saipurumandla/irrigation-ha/cad/stl/box.stl

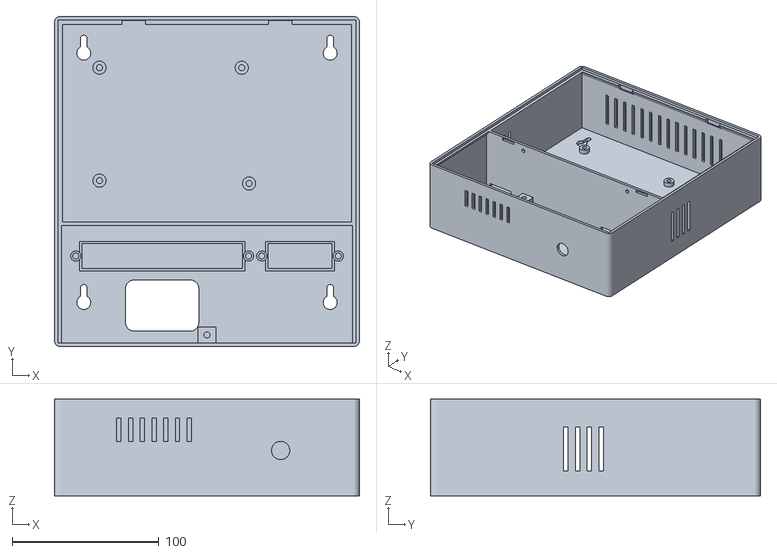
[picture p1: CAD file, 2026-11-06]
cad/stl/box.stl
208.0 x 225.0 x 66.0
