saipurumandla/irrigation-ha/cad/stl/wire_guard.stl

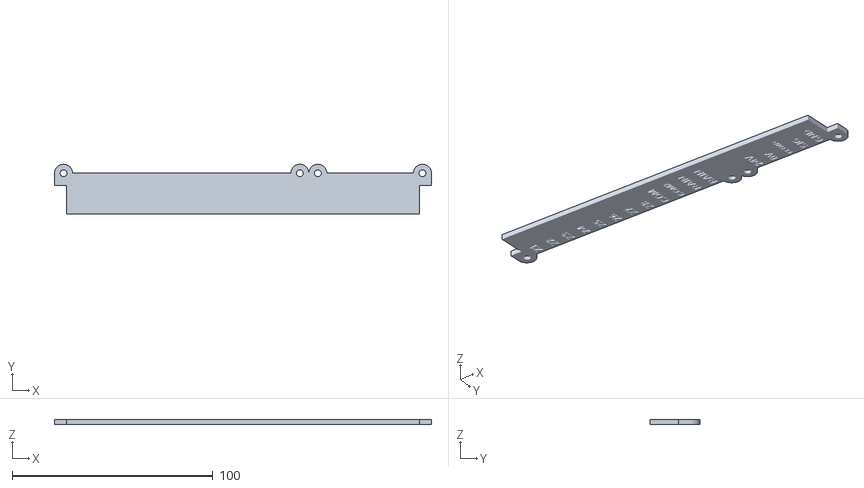
[picture p2: CAD file, 2026-11-06]
cad/stl/wire_guard.stl
188.0 x 24.7 x 2.40
