saipurumandla/irrigation-ha/cad/stl/thumb_knob.stl

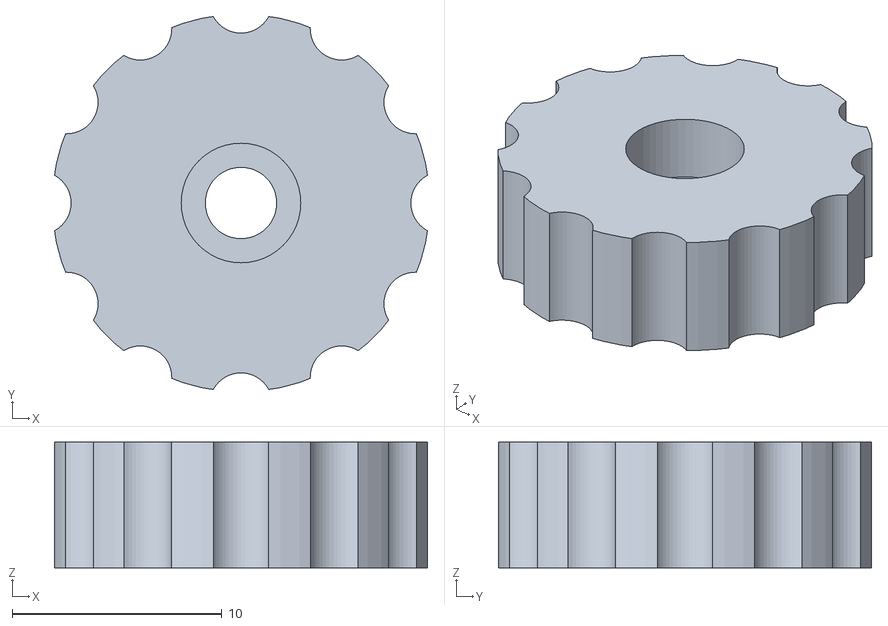
[picture p3: CAD file, 2026-11-06]
cad/stl/thumb_knob.stl
17.8 x 17.8 x 6.00
