saipurumandla/irrigation-ha/cad/stl/lid.stl

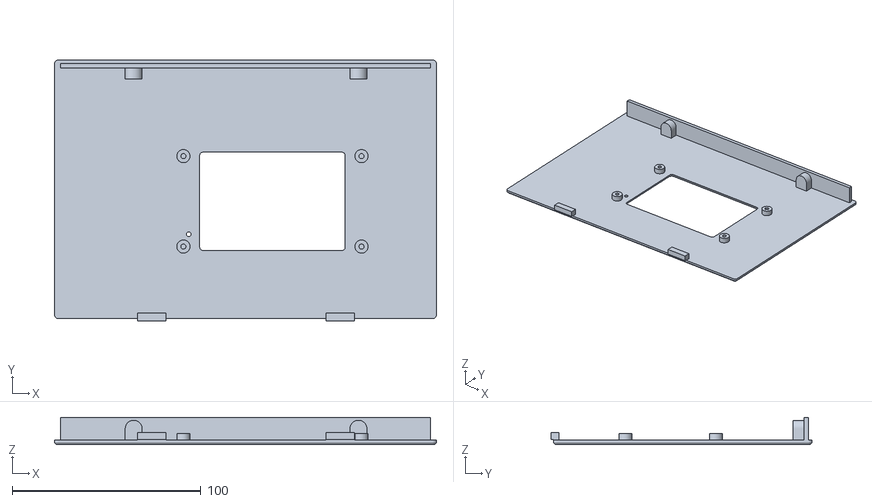
[picture p4: CAD file, 2026-11-06]
cad/stl/lid.stl
202.6 x 138.5 x 14.4
