saipurumandla/irrigation-ha/cad/stl/base.stl

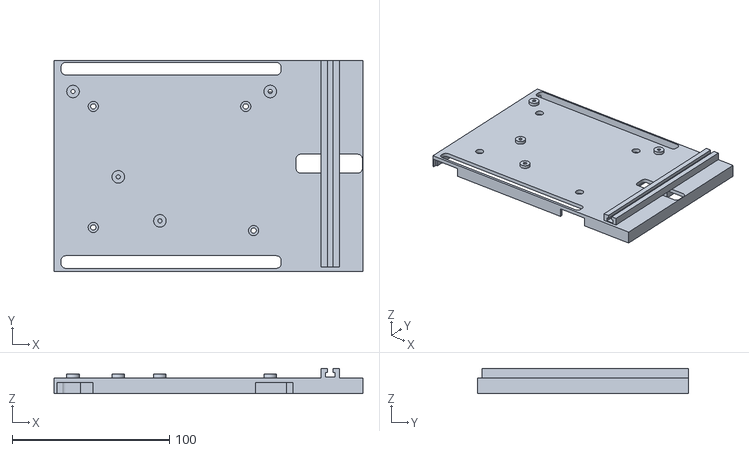
[picture p5: CAD file, 2026-11-06]
cad/stl/base.stl
196.6 x 134.2 x 16.0
