saipurumandla/irrigation-ha/cad/stl/wiring_cover.stl

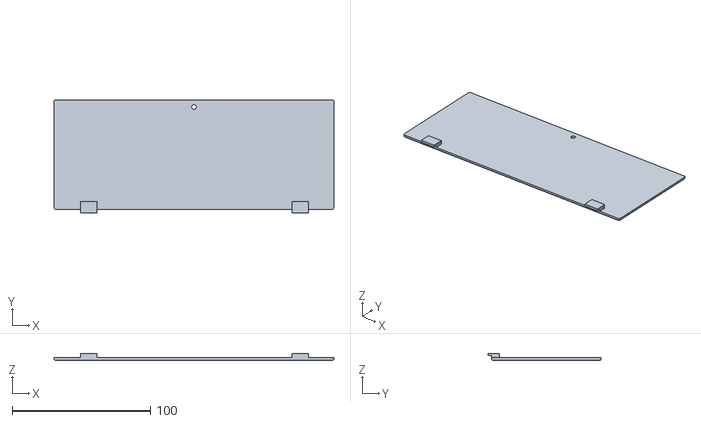
[picture p6: CAD file, 2026-11-06]
cad/stl/wiring_cover.stl
202.6 x 82.0 x 5.40
