saipurumandla/irrigation-ha/cad/stl/clips_labels.stl

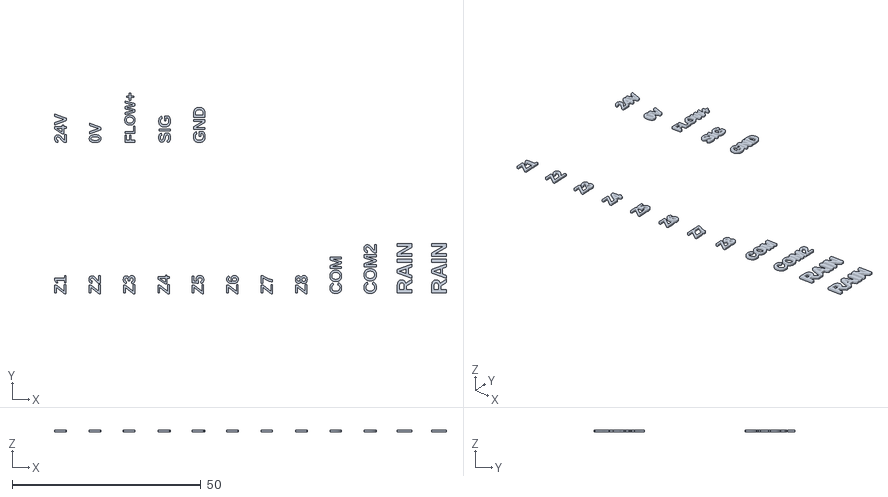
[picture p7: CAD file, 2026-11-06]
cad/stl/clips_labels.stl
103.9 x 53.1 x 0.61
