saipurumandla/irrigation-ha/cad/stl/clips.stl

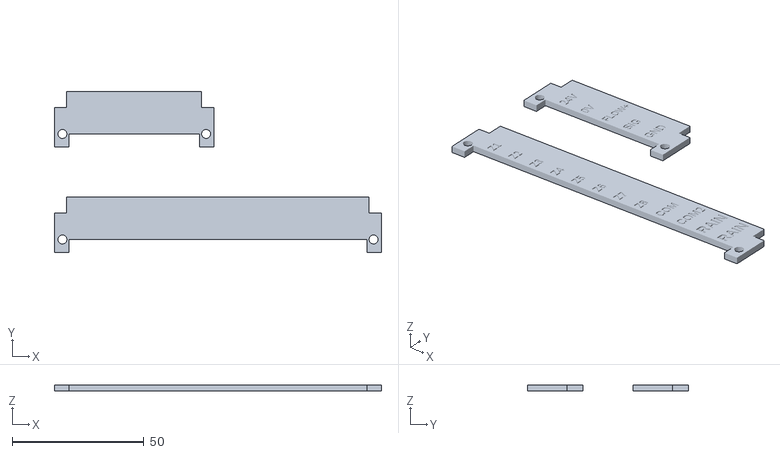
[picture p8: CAD file, 2026-11-06]
cad/stl/clips.stl
124.0 x 61.1 x 2.40
