saipurumandla/irrigation-ha/cad/stl/wall_template.stl

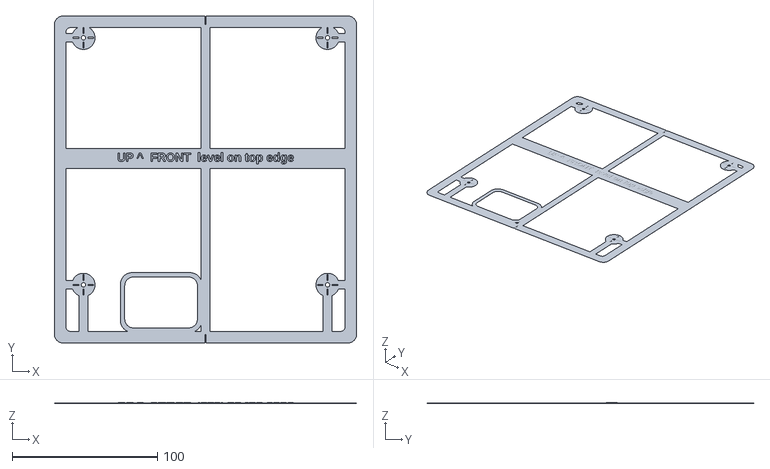
[picture p9: CAD file, 2026-11-06]
cad/stl/wall_template.stl
208.0 x 225.0 x 0.99
