saipurumandla/irrigation-ha/cad/stl/transformer_cover.stl

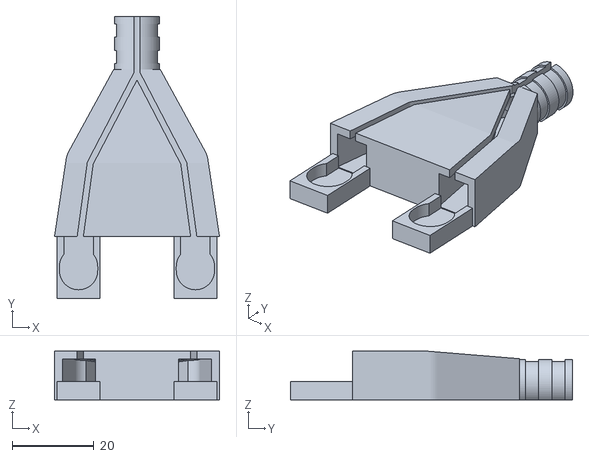
[picture p10: CAD file, 2026-11-06]
cad/stl/transformer_cover.stl
40.5 x 69.3 x 12.0
