saipurumandla/irrigation-ha/firmware/irrigation-screen.yaml

# Irrigation screen: Hosyond / LCDWIKI ES3C35P (ESP32-S3, 8 MB PSRAM, 16 MB flash), 3.5" IPS
# 320x480, ST77922 over QSPI with the ST77922's own (Sitronix) touch on I2C 0x55. It sits in the
# irrigation case's lid and talks to the A8 over its UART socket (5V GND TXD RXD -> A8 S1/S2).
#
# The irrigation box's face: Home, Zones, Schedule, History, Settings. See docs/irrigation-screen.md.
# Pins (ES3C35P spec V1.0 + schematic): LCD CS 10, CLK 12, D0-D3 11/13/14/9; GPIO48 resets the
# whole ST77922 (display and touch); backlight 41 (high = on); touch SDA 38, SCL 39, INT 47; RGB LED 40; audio amp
# enable 1 (low = on); UART0 TX 43 / RX 44 (the A8 link).
# Panel init: the seller's table, read from the factory flash backup
# (~/esp-backups/es3c35p-screen-factory-2026-11-05.bin); see components/st77922_qspi.

substitutions:
  name: irrigation-screen
  friendly_name: Irrigation screen
  # Black edge drawn on the left (and optionally bottom) to balance the panel's own black edge (px).
  bezel_left: "30"
  bezel_bottom: "0"
  # Light theme (chosen 2026-11-05: hides the backlight bleed)
  paper: "0xE9EEF2"
  ink: "0x1B2733"
  muted: "0x5B6B78"
  # Backlight: day hours, idle dim and off (the board has no light sensor).
  day_from: "7"
  day_until: "20"
  dim_after: "30"
  off_after: "60"

esphome:
  name: ${name}
  friendly_name: ${friendly_name}
  includes:
    - screen/a8_link_client.h
    - screen/ui.h
    - screen/history.h
  on_boot:
    priority: 600
    then:
      - output.turn_on: amp_off   # keep the speaker amplifier off (nothing plays audio)
      - lambda: a8link::client().begin(id(a8_uart));
      - lambda: hist::history().begin();
      - script.execute: apply_brightness

esp32:
  variant: esp32s3
  flash_size: 16MB
  framework:
    type: esp-idf

psram:
  mode: octal
  speed: 80MHz

logger:
  hardware_uart: USB_SERIAL_JTAG   # UART0 (the socket) is kept for the A8

api:
  encryption:
    key: !secret irrigation_screen_api_key

ota:
  - platform: esphome
    password: !secret irrigation_screen_ota_password

wifi:
  ssid: !secret wifi_ssid
  password: !secret wifi_password
  ap:
    ssid: "${friendly_name} setup"
  on_connect:
    - lvgl.label.update: {id: wifi_icon, text: "\U000F05A9", text_color: 0x2E7D32}
  on_disconnect:
    - lvgl.label.update: {id: wifi_icon, text: "\U000F05AA", text_color: 0xB3261E}

captive_portal:

text_sensor:
  - platform: wifi_info
    scan_results:
      name: "Wi-Fi networks seen"
      entity_category: diagnostic
    ssid:
      id: wifi_ssid_now
      on_value:
        - lambda: ui::wifi_ssid_cache() = x;
      name: "Wi-Fi network"
      entity_category: diagnostic

# The wired link to the A8 (irrigation.yaml), on the screen's UART socket: our TXD
# (GPIO43) goes to the A8's RX (S2), our RXD (GPIO44) to its TX (S1). Logs go to USB instead.
uart:
  - id: a8_uart
    tx_pin: GPIO43
    rx_pin: GPIO44
    baud_rate: 115200
    rx_buffer_size: 4096

interval:
  - interval: 20ms
    then:
      - lambda: a8link::client().poll();
  - interval: 1s
    then:
      - lambda: a8link::client().tick();
      - lambda: |-
          const long now = id(sntp_time).now().is_valid() ? (long) id(sntp_time).now().timestamp : 0;
          hist::history().set_now(now);
          hist::history().tick(now);
          if (hist::history().changed) { hist::history().changed = false; id(refresh_history).execute(); }
      - if:   # the countdown
          condition:
            lambda: return a8link::client().seconds_left() > 0;
          then:
            - script.execute: refresh_home
            - script.execute: refresh_zones
            - script.execute: refresh_zone
  - interval: 300ms
    then:
      - if:
          condition:
            lambda: return a8link::client().take_changed();
          then:
            - script.execute: refresh_home
            - script.execute: refresh_zones
            - script.execute: refresh_zone
            - script.execute: refresh_sched
            - script.execute: refresh_prog
            - script.execute: refresh_settings

time:
  - platform: sntp
    id: sntp_time
    timezone: America/New_York
    on_time_sync:
      - script.execute: update_clock
    on_time:
      - seconds: 0
        then:
          - script.execute: update_clock
          - script.execute: refresh_home   # day/night icon, "Today" after midnight
          - if:   # follow day/night while awake (not dimmed or off)
              condition:
                lambda: return id(screen_state) == 0;
              then:
                - script.execute: apply_brightness

globals:
  # Backlight levels (%), changed by sliding the left bezel; kept across restarts.
  - id: cur_zone   # the zone open on the zone page (1-8)
    type: int
    initial_value: "1"
  - id: run_min    # minutes chosen on the zone page
    type: int
    initial_value: "10"
  - id: run_zone_pending   # Run pressed: the zone to start once its minutes are sent (0 = none)
    type: int
    initial_value: "0"
  - id: cur_prog     # the program open on the program page (0-3 = A-D)
    type: int
    initial_value: "0"
  - id: prog_shown   # programs added this session but still empty (bit per program)
    type: int
    initial_value: "0"
  - id: wf_ssid       # the network chosen on the Wi-Fi page
    type: std::string
    initial_value: '""'
  - id: hist_view    # 0 = 7 days, 1 = one day
    type: int
    initial_value: "0"
  - id: hist_day     # the day shown in the day view (local day number)
    type: int
    initial_value: "0"
  # Settings PIN: on the screen only (not an HA entity). Always on; default 0000.
  - id: settings_pin_v2
    type: int
    restore_value: true
    initial_value: "0"
  - id: settings_unlocked   # until the screen next turns off
    type: bool
    initial_value: "false"
  - id: pin_mode    # 0 = unlock Settings, 1 = new PIN, 2 = confirm new PIN
    type: int
    initial_value: "0"
  - id: pin_buf
    type: std::string
    initial_value: '""'
  - id: pin_first
    type: std::string
    initial_value: '""'
  - id: slide_last_y
    type: int
    initial_value: "0"
  # While the bezel is being slid: the level shown, saved to the number only on release (each
  # step used to set the number, which re-ran refresh_settings and sent a state to HA every few ms).
  - id: slide_val
    type: float
    initial_value: "0"
  - id: sliding
    type: bool
    initial_value: "false"
  - id: screen_state   # 0 awake, 1 dimmed, 2 off
    type: int
    initial_value: "0"
  - id: is_daytime
    type: std::function<bool()>
    initial_value: |-
      []() {
        auto t = id(sntp_time).now();
        if (!t.is_valid()) return true;
        return t.hour >= (int) id(scr_day_from).state && t.hour < (int) id(scr_day_until).state;
      }

script:
  - id: pin_show
    then:
      - lambda: |-
          static const char *const t[] = {"Enter PIN", "New PIN (4 digits)", "Enter it again"};
          ui::text(id(pin_title), t[id(pin_mode) % 3]);
          ui::text(id(pin_msg), "");
          ui::text(id(pin_dots), "");
      - lvgl.widget.show: pin_sheet
  - id: pin_entered
    then:
      - lambda: |-
          std::string dots;
          for (size_t i = 0; i < 4; i++) dots += i < id(pin_buf).size() ? "* " : "_ ";
          ui::text(id(pin_dots), dots);
          ui::text(id(pin_msg), "");
          if (id(pin_buf).size() < 4) return;
          const std::string got = id(pin_buf);
          id(pin_buf) = "";
          if (id(pin_mode) == 0) {
            if (atoi(got.c_str()) == id(settings_pin_v2)) {
              id(settings_unlocked) = true;
              ui::vis(id(pin_sheet), false);
              id(refresh_settings).execute();
              lv_scr_load(ui::as_obj(id(settings_page)));
            } else {
              ui::text(id(pin_msg), "Wrong PIN");
              ui::text(id(pin_dots), "_ _ _ _ ");
            }
          } else if (id(pin_mode) == 1) {
            id(pin_first) = got;
            id(pin_mode) = 2;
            ui::text(id(pin_title), "Enter it again");
            ui::text(id(pin_dots), "_ _ _ _ ");
          } else {
            if (got == id(pin_first)) {
              id(settings_pin_v2) = atoi(got.c_str());
              id(settings_unlocked) = true;
              ui::vis(id(pin_sheet), false);
              id(refresh_settings).execute();
            } else {
              id(pin_mode) = 1;
              ui::text(id(pin_title), "New PIN (4 digits)");
              ui::text(id(pin_msg), "Didn't match - start again");
              ui::text(id(pin_dots), "_ _ _ _ ");
            }
          }
  - id: refresh_history
    then:
      - lambda: |-
          const long now = id(sntp_time).now().timestamp;
          if (now < 1600000000L) return;
          auto &h = hist::history();
          const int32_t today = hist::local_day(now);
          static const char *const wd[] = {"Sun", "Mon", "Tue", "Wed", "Thu", "Fri", "Sat"};
          static const char *const mo[] = {"Jan","Feb","Mar","Apr","May","Jun","Jul","Aug","Sep","Oct","Nov","Dec"};
          const bool week = id(hist_view) == 0;
          ui::vis(id(hv_week), week);
          ui::vis(id(hv_day), !week);
          ui::bg(id(hs_week), week ? 0x1E6091 : 0xE9EEF2); ui::fg(id(hs_week_l), week ? 0xFFFFFF : ${ink});
          ui::bg(id(hs_day), !week ? 0x1E6091 : 0xE9EEF2); ui::fg(id(hs_day_l), !week ? 0xFFFFFF : ${ink});
          // 7 days: bars scaled to the busiest day
          uint32_t maxs = 600;
          for (int d = 0; d < 7; d++) maxs = std::max(maxs, h.secs(today - (6 - d), 0));
          bool used[8] = {};
          const int H = 150;
          { const int32_t day = today - (6 - 0);
            const auto lt = esphome::ESPTime::from_epoch_local((time_t) (now - (long) (6 - 0) * 86400));
            ui::text(id(hw0_l), 0 == 6 ? std::string("Today") : std::string(wd[(lt.day_of_week + 6) % 7]));
            const uint32_t tot = h.secs(day, 0);
            ui::text(id(hw0_t), tot ? std::to_string((tot + 59) / 60) + "m" : std::string(""));
            int ybase = -22;
            { const uint32_t s = h.secs(day, 1); const int hh = s ? std::max(2, (int) ((uint64_t) s * H / maxs)) : 0;
              ui::vis(id(hw0_s0), hh > 0);
              if (hh > 0) { used[0] = true; lv_obj_set_height(ui::as_obj(id(hw0_s0)), hh); lv_obj_set_y(ui::as_obj(id(hw0_s0)), ybase); ybase -= hh; } }
            { const uint32_t s = h.secs(day, 2); const int hh = s ? std::max(2, (int) ((uint64_t) s * H / maxs)) : 0;
              ui::vis(id(hw0_s1), hh > 0);
              if (hh > 0) { used[1] = true; lv_obj_set_height(ui::as_obj(id(hw0_s1)), hh); lv_obj_set_y(ui::as_obj(id(hw0_s1)), ybase); ybase -= hh; } }
            { const uint32_t s = h.secs(day, 3); const int hh = s ? std::max(2, (int) ((uint64_t) s * H / maxs)) : 0;
              ui::vis(id(hw0_s2), hh > 0);
              if (hh > 0) { used[2] = true; lv_obj_set_height(ui::as_obj(id(hw0_s2)), hh); lv_obj_set_y(ui::as_obj(id(hw0_s2)), ybase); ybase -= hh; } }
            { const uint32_t s = h.secs(day, 4); const int hh = s ? std::max(2, (int) ((uint64_t) s * H / maxs)) : 0;
              ui::vis(id(hw0_s3), hh > 0);
              if (hh > 0) { used[3] = true; lv_obj_set_height(ui::as_obj(id(hw0_s3)), hh); lv_obj_set_y(ui::as_obj(id(hw0_s3)), ybase); ybase -= hh; } }
            { const uint32_t s = h.secs(day, 5); const int hh = s ? std::max(2, (int) ((uint64_t) s * H / maxs)) : 0;
              ui::vis(id(hw0_s4), hh > 0);
              if (hh > 0) { used[4] = true; lv_obj_set_height(ui::as_obj(id(hw0_s4)), hh); lv_obj_set_y(ui::as_obj(id(hw0_s4)), ybase); ybase -= hh; } }
            { const uint32_t s = h.secs(day, 6); const int hh = s ? std::max(2, (int) ((uint64_t) s * H / maxs)) : 0;
              ui::vis(id(hw0_s5), hh > 0);
              if (hh > 0) { used[5] = true; lv_obj_set_height(ui::as_obj(id(hw0_s5)), hh); lv_obj_set_y(ui::as_obj(id(hw0_s5)), ybase); ybase -= hh; } }
            { const uint32_t s = h.secs(day, 7); const int hh = s ? std::max(2, (int) ((uint64_t) s * H / maxs)) : 0;
              ui::vis(id(hw0_s6), hh > 0);
              if (hh > 0) { used[6] = true; lv_obj_set_height(ui::as_obj(id(hw0_s6)), hh); lv_obj_set_y(ui::as_obj(id(hw0_s6)), ybase); ybase -= hh; } }
            { const uint32_t s = h.secs(day, 8); const int hh = s ? std::max(2, (int) ((uint64_t) s * H / maxs)) : 0;
              ui::vis(id(hw0_s7), hh > 0);
              if (hh > 0) { used[7] = true; lv_obj_set_height(ui::as_obj(id(hw0_s7)), hh); lv_obj_set_y(ui::as_obj(id(hw0_s7)), ybase); ybase -= hh; } }
          }
          { const int32_t day = today - (6 - 1);
            const auto lt = esphome::ESPTime::from_epoch_local((time_t) (now - (long) (6 - 1) * 86400));
            ui::text(id(hw1_l), 1 == 6 ? std::string("Today") : std::string(wd[(lt.day_of_week + 6) % 7]));
            const uint32_t tot = h.secs(day, 0);
            ui::text(id(hw1_t), tot ? std::to_string((tot + 59) / 60) + "m" : std::string(""));
            int ybase = -22;
            { const uint32_t s = h.secs(day, 1); const int hh = s ? std::max(2, (int) ((uint64_t) s * H / maxs)) : 0;
              ui::vis(id(hw1_s0), hh > 0);
              if (hh > 0) { used[0] = true; lv_obj_set_height(ui::as_obj(id(hw1_s0)), hh); lv_obj_set_y(ui::as_obj(id(hw1_s0)), ybase); ybase -= hh; } }
            { const uint32_t s = h.secs(day, 2); const int hh = s ? std::max(2, (int) ((uint64_t) s * H / maxs)) : 0;
              ui::vis(id(hw1_s1), hh > 0);
              if (hh > 0) { used[1] = true; lv_obj_set_height(ui::as_obj(id(hw1_s1)), hh); lv_obj_set_y(ui::as_obj(id(hw1_s1)), ybase); ybase -= hh; } }
            { const uint32_t s = h.secs(day, 3); const int hh = s ? std::max(2, (int) ((uint64_t) s * H / maxs)) : 0;
              ui::vis(id(hw1_s2), hh > 0);
              if (hh > 0) { used[2] = true; lv_obj_set_height(ui::as_obj(id(hw1_s2)), hh); lv_obj_set_y(ui::as_obj(id(hw1_s2)), ybase); ybase -= hh; } }
            { const uint32_t s = h.secs(day, 4); const int hh = s ? std::max(2, (int) ((uint64_t) s * H / maxs)) : 0;
              ui::vis(id(hw1_s3), hh > 0);
              if (hh > 0) { used[3] = true; lv_obj_set_height(ui::as_obj(id(hw1_s3)), hh); lv_obj_set_y(ui::as_obj(id(hw1_s3)), ybase); ybase -= hh; } }
            { const uint32_t s = h.secs(day, 5); const int hh = s ? std::max(2, (int) ((uint64_t) s * H / maxs)) : 0;
              ui::vis(id(hw1_s4), hh > 0);
              if (hh > 0) { used[4] = true; lv_obj_set_height(ui::as_obj(id(hw1_s4)), hh); lv_obj_set_y(ui::as_obj(id(hw1_s4)), ybase); ybase -= hh; } }
            { const uint32_t s = h.secs(day, 6); const int hh = s ? std::max(2, (int) ((uint64_t) s * H / maxs)) : 0;
              ui::vis(id(hw1_s5), hh > 0);
              if (hh > 0) { used[5] = true; lv_obj_set_height(ui::as_obj(id(hw1_s5)), hh); lv_obj_set_y(ui::as_obj(id(hw1_s5)), ybase); ybase -= hh; } }
            { const uint32_t s = h.secs(day, 7); const int hh = s ? std::max(2, (int) ((uint64_t) s * H / maxs)) : 0;
              ui::vis(id(hw1_s6), hh > 0);
              if (hh > 0) { used[6] = true; lv_obj_set_height(ui::as_obj(id(hw1_s6)), hh); lv_obj_set_y(ui::as_obj(id(hw1_s6)), ybase); ybase -= hh; } }
            { const uint32_t s = h.secs(day, 8); const int hh = s ? std::max(2, (int) ((uint64_t) s * H / maxs)) : 0;
              ui::vis(id(hw1_s7), hh > 0);
              if (hh > 0) { used[7] = true; lv_obj_set_height(ui::as_obj(id(hw1_s7)), hh); lv_obj_set_y(ui::as_obj(id(hw1_s7)), ybase); ybase -= hh; } }
          }
          { const int32_t day = today - (6 - 2);
            const auto lt = esphome::ESPTime::from_epoch_local((time_t) (now - (long) (6 - 2) * 86400));
            ui::text(id(hw2_l), 2 == 6 ? std::string("Today") : std::string(wd[(lt.day_of_week + 6) % 7]));
            const uint32_t tot = h.secs(day, 0);
            ui::text(id(hw2_t), tot ? std::to_string((tot + 59) / 60) + "m" : std::string(""));
            int ybase = -22;
            { const uint32_t s = h.secs(day, 1); const int hh = s ? std::max(2, (int) ((uint64_t) s * H / maxs)) : 0;
              ui::vis(id(hw2_s0), hh > 0);
              if (hh > 0) { used[0] = true; lv_obj_set_height(ui::as_obj(id(hw2_s0)), hh); lv_obj_set_y(ui::as_obj(id(hw2_s0)), ybase); ybase -= hh; } }
            { const uint32_t s = h.secs(day, 2); const int hh = s ? std::max(2, (int) ((uint64_t) s * H / maxs)) : 0;
              ui::vis(id(hw2_s1), hh > 0);
              if (hh > 0) { used[1] = true; lv_obj_set_height(ui::as_obj(id(hw2_s1)), hh); lv_obj_set_y(ui::as_obj(id(hw2_s1)), ybase); ybase -= hh; } }
            { const uint32_t s = h.secs(day, 3); const int hh = s ? std::max(2, (int) ((uint64_t) s * H / maxs)) : 0;
              ui::vis(id(hw2_s2), hh > 0);
              if (hh > 0) { used[2] = true; lv_obj_set_height(ui::as_obj(id(hw2_s2)), hh); lv_obj_set_y(ui::as_obj(id(hw2_s2)), ybase); ybase -= hh; } }
            { const uint32_t s = h.secs(day, 4); const int hh = s ? std::max(2, (int) ((uint64_t) s * H / maxs)) : 0;
              ui::vis(id(hw2_s3), hh > 0);
              if (hh > 0) { used[3] = true; lv_obj_set_height(ui::as_obj(id(hw2_s3)), hh); lv_obj_set_y(ui::as_obj(id(hw2_s3)), ybase); ybase -= hh; } }
            { const uint32_t s = h.secs(day, 5); const int hh = s ? std::max(2, (int) ((uint64_t) s * H / maxs)) : 0;
              ui::vis(id(hw2_s4), hh > 0);
              if (hh > 0) { used[4] = true; lv_obj_set_height(ui::as_obj(id(hw2_s4)), hh); lv_obj_set_y(ui::as_obj(id(hw2_s4)), ybase); ybase -= hh; } }
            { const uint32_t s = h.secs(day, 6); const int hh = s ? std::max(2, (int) ((uint64_t) s * H / maxs)) : 0;
              ui::vis(id(hw2_s5), hh > 0);
              if (hh > 0) { used[5] = true; lv_obj_set_height(ui::as_obj(id(hw2_s5)), hh); lv_obj_set_y(ui::as_obj(id(hw2_s5)), ybase); ybase -= hh; } }
            { const uint32_t s = h.secs(day, 7); const int hh = s ? std::max(2, (int) ((uint64_t) s * H / maxs)) : 0;
              ui::vis(id(hw2_s6), hh > 0);
              if (hh > 0) { used[6] = true; lv_obj_set_height(ui::as_obj(id(hw2_s6)), hh); lv_obj_set_y(ui::as_obj(id(hw2_s6)), ybase); ybase -= hh; } }
            { const uint32_t s = h.secs(day, 8); const int hh = s ? std::max(2, (int) ((uint64_t) s * H / maxs)) : 0;
              ui::vis(id(hw2_s7), hh > 0);
              if (hh > 0) { used[7] = true; lv_obj_set_height(ui::as_obj(id(hw2_s7)), hh); lv_obj_set_y(ui::as_obj(id(hw2_s7)), ybase); ybase -= hh; } }
          }
          { const int32_t day = today - (6 - 3);
            const auto lt = esphome::ESPTime::from_epoch_local((time_t) (now - (long) (6 - 3) * 86400));
            ui::text(id(hw3_l), 3 == 6 ? std::string("Today") : std::string(wd[(lt.day_of_week + 6) % 7]));
            const uint32_t tot = h.secs(day, 0);
            ui::text(id(hw3_t), tot ? std::to_string((tot + 59) / 60) + "m" : std::string(""));
            int ybase = -22;
            { const uint32_t s = h.secs(day, 1); const int hh = s ? std::max(2, (int) ((uint64_t) s * H / maxs)) : 0;
              ui::vis(id(hw3_s0), hh > 0);
              if (hh > 0) { used[0] = true; lv_obj_set_height(ui::as_obj(id(hw3_s0)), hh); lv_obj_set_y(ui::as_obj(id(hw3_s0)), ybase); ybase -= hh; } }
            { const uint32_t s = h.secs(day, 2); const int hh = s ? std::max(2, (int) ((uint64_t) s * H / maxs)) : 0;
              ui::vis(id(hw3_s1), hh > 0);
              if (hh > 0) { used[1] = true; lv_obj_set_height(ui::as_obj(id(hw3_s1)), hh); lv_obj_set_y(ui::as_obj(id(hw3_s1)), ybase); ybase -= hh; } }
            { const uint32_t s = h.secs(day, 3); const int hh = s ? std::max(2, (int) ((uint64_t) s * H / maxs)) : 0;
              ui::vis(id(hw3_s2), hh > 0);
              if (hh > 0) { used[2] = true; lv_obj_set_height(ui::as_obj(id(hw3_s2)), hh); lv_obj_set_y(ui::as_obj(id(hw3_s2)), ybase); ybase -= hh; } }
            { const uint32_t s = h.secs(day, 4); const int hh = s ? std::max(2, (int) ((uint64_t) s * H / maxs)) : 0;
              ui::vis(id(hw3_s3), hh > 0);
              if (hh > 0) { used[3] = true; lv_obj_set_height(ui::as_obj(id(hw3_s3)), hh); lv_obj_set_y(ui::as_obj(id(hw3_s3)), ybase); ybase -= hh; } }
            { const uint32_t s = h.secs(day, 5); const int hh = s ? std::max(2, (int) ((uint64_t) s * H / maxs)) : 0;
              ui::vis(id(hw3_s4), hh > 0);
              if (hh > 0) { used[4] = true; lv_obj_set_height(ui::as_obj(id(hw3_s4)), hh); lv_obj_set_y(ui::as_obj(id(hw3_s4)), ybase); ybase -= hh; } }
            { const uint32_t s = h.secs(day, 6); const int hh = s ? std::max(2, (int) ((uint64_t) s * H / maxs)) : 0;
              ui::vis(id(hw3_s5), hh > 0);
              if (hh > 0) { used[5] = true; lv_obj_set_height(ui::as_obj(id(hw3_s5)), hh); lv_obj_set_y(ui::as_obj(id(hw3_s5)), ybase); ybase -= hh; } }
            { const uint32_t s = h.secs(day, 7); const int hh = s ? std::max(2, (int) ((uint64_t) s * H / maxs)) : 0;
              ui::vis(id(hw3_s6), hh > 0);
              if (hh > 0) { used[6] = true; lv_obj_set_height(ui::as_obj(id(hw3_s6)), hh); lv_obj_set_y(ui::as_obj(id(hw3_s6)), ybase); ybase -= hh; } }
            { const uint32_t s = h.secs(day, 8); const int hh = s ? std::max(2, (int) ((uint64_t) s * H / maxs)) : 0;
              ui::vis(id(hw3_s7), hh > 0);
              if (hh > 0) { used[7] = true; lv_obj_set_height(ui::as_obj(id(hw3_s7)), hh); lv_obj_set_y(ui::as_obj(id(hw3_s7)), ybase); ybase -= hh; } }
          }
          { const int32_t day = today - (6 - 4);
            const auto lt = esphome::ESPTime::from_epoch_local((time_t) (now - (long) (6 - 4) * 86400));
            ui::text(id(hw4_l), 4 == 6 ? std::string("Today") : std::string(wd[(lt.day_of_week + 6) % 7]));
            const uint32_t tot = h.secs(day, 0);
            ui::text(id(hw4_t), tot ? std::to_string((tot + 59) / 60) + "m" : std::string(""));
            int ybase = -22;
            { const uint32_t s = h.secs(day, 1); const int hh = s ? std::max(2, (int) ((uint64_t) s * H / maxs)) : 0;
              ui::vis(id(hw4_s0), hh > 0);
              if (hh > 0) { used[0] = true; lv_obj_set_height(ui::as_obj(id(hw4_s0)), hh); lv_obj_set_y(ui::as_obj(id(hw4_s0)), ybase); ybase -= hh; } }
            { const uint32_t s = h.secs(day, 2); const int hh = s ? std::max(2, (int) ((uint64_t) s * H / maxs)) : 0;
              ui::vis(id(hw4_s1), hh > 0);
              if (hh > 0) { used[1] = true; lv_obj_set_height(ui::as_obj(id(hw4_s1)), hh); lv_obj_set_y(ui::as_obj(id(hw4_s1)), ybase); ybase -= hh; } }
            { const uint32_t s = h.secs(day, 3); const int hh = s ? std::max(2, (int) ((uint64_t) s * H / maxs)) : 0;
              ui::vis(id(hw4_s2), hh > 0);
              if (hh > 0) { used[2] = true; lv_obj_set_height(ui::as_obj(id(hw4_s2)), hh); lv_obj_set_y(ui::as_obj(id(hw4_s2)), ybase); ybase -= hh; } }
            { const uint32_t s = h.secs(day, 4); const int hh = s ? std::max(2, (int) ((uint64_t) s * H / maxs)) : 0;
              ui::vis(id(hw4_s3), hh > 0);
              if (hh > 0) { used[3] = true; lv_obj_set_height(ui::as_obj(id(hw4_s3)), hh); lv_obj_set_y(ui::as_obj(id(hw4_s3)), ybase); ybase -= hh; } }
            { const uint32_t s = h.secs(day, 5); const int hh = s ? std::max(2, (int) ((uint64_t) s * H / maxs)) : 0;
              ui::vis(id(hw4_s4), hh > 0);
              if (hh > 0) { used[4] = true; lv_obj_set_height(ui::as_obj(id(hw4_s4)), hh); lv_obj_set_y(ui::as_obj(id(hw4_s4)), ybase); ybase -= hh; } }
            { const uint32_t s = h.secs(day, 6); const int hh = s ? std::max(2, (int) ((uint64_t) s * H / maxs)) : 0;
              ui::vis(id(hw4_s5), hh > 0);
              if (hh > 0) { used[5] = true; lv_obj_set_height(ui::as_obj(id(hw4_s5)), hh); lv_obj_set_y(ui::as_obj(id(hw4_s5)), ybase); ybase -= hh; } }
            { const uint32_t s = h.secs(day, 7); const int hh = s ? std::max(2, (int) ((uint64_t) s * H / maxs)) : 0;
              ui::vis(id(hw4_s6), hh > 0);
              if (hh > 0) { used[6] = true; lv_obj_set_height(ui::as_obj(id(hw4_s6)), hh); lv_obj_set_y(ui::as_obj(id(hw4_s6)), ybase); ybase -= hh; } }
            { const uint32_t s = h.secs(day, 8); const int hh = s ? std::max(2, (int) ((uint64_t) s * H / maxs)) : 0;
              ui::vis(id(hw4_s7), hh > 0);
              if (hh > 0) { used[7] = true; lv_obj_set_height(ui::as_obj(id(hw4_s7)), hh); lv_obj_set_y(ui::as_obj(id(hw4_s7)), ybase); ybase -= hh; } }
          }
          { const int32_t day = today - (6 - 5);
            const auto lt = esphome::ESPTime::from_epoch_local((time_t) (now - (long) (6 - 5) * 86400));
            ui::text(id(hw5_l), 5 == 6 ? std::string("Today") : std::string(wd[(lt.day_of_week + 6) % 7]));
            const uint32_t tot = h.secs(day, 0);
            ui::text(id(hw5_t), tot ? std::to_string((tot + 59) / 60) + "m" : std::string(""));
            int ybase = -22;
            { const uint32_t s = h.secs(day, 1); const int hh = s ? std::max(2, (int) ((uint64_t) s * H / maxs)) : 0;
              ui::vis(id(hw5_s0), hh > 0);
              if (hh > 0) { used[0] = true; lv_obj_set_height(ui::as_obj(id(hw5_s0)), hh); lv_obj_set_y(ui::as_obj(id(hw5_s0)), ybase); ybase -= hh; } }
            { const uint32_t s = h.secs(day, 2); const int hh = s ? std::max(2, (int) ((uint64_t) s * H / maxs)) : 0;
              ui::vis(id(hw5_s1), hh > 0);
              if (hh > 0) { used[1] = true; lv_obj_set_height(ui::as_obj(id(hw5_s1)), hh); lv_obj_set_y(ui::as_obj(id(hw5_s1)), ybase); ybase -= hh; } }
            { const uint32_t s = h.secs(day, 3); const int hh = s ? std::max(2, (int) ((uint64_t) s * H / maxs)) : 0;
              ui::vis(id(hw5_s2), hh > 0);
              if (hh > 0) { used[2] = true; lv_obj_set_height(ui::as_obj(id(hw5_s2)), hh); lv_obj_set_y(ui::as_obj(id(hw5_s2)), ybase); ybase -= hh; } }
            { const uint32_t s = h.secs(day, 4); const int hh = s ? std::max(2, (int) ((uint64_t) s * H / maxs)) : 0;
              ui::vis(id(hw5_s3), hh > 0);
              if (hh > 0) { used[3] = true; lv_obj_set_height(ui::as_obj(id(hw5_s3)), hh); lv_obj_set_y(ui::as_obj(id(hw5_s3)), ybase); ybase -= hh; } }
            { const uint32_t s = h.secs(day, 5); const int hh = s ? std::max(2, (int) ((uint64_t) s * H / maxs)) : 0;
              ui::vis(id(hw5_s4), hh > 0);
              if (hh > 0) { used[4] = true; lv_obj_set_height(ui::as_obj(id(hw5_s4)), hh); lv_obj_set_y(ui::as_obj(id(hw5_s4)), ybase); ybase -= hh; } }
            { const uint32_t s = h.secs(day, 6); const int hh = s ? std::max(2, (int) ((uint64_t) s * H / maxs)) : 0;
              ui::vis(id(hw5_s5), hh > 0);
              if (hh > 0) { used[5] = true; lv_obj_set_height(ui::as_obj(id(hw5_s5)), hh); lv_obj_set_y(ui::as_obj(id(hw5_s5)), ybase); ybase -= hh; } }
            { const uint32_t s = h.secs(day, 7); const int hh = s ? std::max(2, (int) ((uint64_t) s * H / maxs)) : 0;
              ui::vis(id(hw5_s6), hh > 0);
              if (hh > 0) { used[6] = true; lv_obj_set_height(ui::as_obj(id(hw5_s6)), hh); lv_obj_set_y(ui::as_obj(id(hw5_s6)), ybase); ybase -= hh; } }
            { const uint32_t s = h.secs(day, 8); const int hh = s ? std::max(2, (int) ((uint64_t) s * H / maxs)) : 0;
              ui::vis(id(hw5_s7), hh > 0);
              if (hh > 0) { used[7] = true; lv_obj_set_height(ui::as_obj(id(hw5_s7)), hh); lv_obj_set_y(ui::as_obj(id(hw5_s7)), ybase); ybase -= hh; } }
          }
          { const int32_t day = today - (6 - 6);
            const auto lt = esphome::ESPTime::from_epoch_local((time_t) (now - (long) (6 - 6) * 86400));
            ui::text(id(hw6_l), 6 == 6 ? std::string("Today") : std::string(wd[(lt.day_of_week + 6) % 7]));
            const uint32_t tot = h.secs(day, 0);
            ui::text(id(hw6_t), tot ? std::to_string((tot + 59) / 60) + "m" : std::string(""));
            int ybase = -22;
            { const uint32_t s = h.secs(day, 1); const int hh = s ? std::max(2, (int) ((uint64_t) s * H / maxs)) : 0;
              ui::vis(id(hw6_s0), hh > 0);
              if (hh > 0) { used[0] = true; lv_obj_set_height(ui::as_obj(id(hw6_s0)), hh); lv_obj_set_y(ui::as_obj(id(hw6_s0)), ybase); ybase -= hh; } }
            { const uint32_t s = h.secs(day, 2); const int hh = s ? std::max(2, (int) ((uint64_t) s * H / maxs)) : 0;
              ui::vis(id(hw6_s1), hh > 0);
              if (hh > 0) { used[1] = true; lv_obj_set_height(ui::as_obj(id(hw6_s1)), hh); lv_obj_set_y(ui::as_obj(id(hw6_s1)), ybase); ybase -= hh; } }
            { const uint32_t s = h.secs(day, 3); const int hh = s ? std::max(2, (int) ((uint64_t) s * H / maxs)) : 0;
              ui::vis(id(hw6_s2), hh > 0);
              if (hh > 0) { used[2] = true; lv_obj_set_height(ui::as_obj(id(hw6_s2)), hh); lv_obj_set_y(ui::as_obj(id(hw6_s2)), ybase); ybase -= hh; } }
            { const uint32_t s = h.secs(day, 4); const int hh = s ? std::max(2, (int) ((uint64_t) s * H / maxs)) : 0;
              ui::vis(id(hw6_s3), hh > 0);
              if (hh > 0) { used[3] = true; lv_obj_set_height(ui::as_obj(id(hw6_s3)), hh); lv_obj_set_y(ui::as_obj(id(hw6_s3)), ybase); ybase -= hh; } }
            { const uint32_t s = h.secs(day, 5); const int hh = s ? std::max(2, (int) ((uint64_t) s * H / maxs)) : 0;
              ui::vis(id(hw6_s4), hh > 0);
              if (hh > 0) { used[4] = true; lv_obj_set_height(ui::as_obj(id(hw6_s4)), hh); lv_obj_set_y(ui::as_obj(id(hw6_s4)), ybase); ybase -= hh; } }
            { const uint32_t s = h.secs(day, 6); const int hh = s ? std::max(2, (int) ((uint64_t) s * H / maxs)) : 0;
              ui::vis(id(hw6_s5), hh > 0);
              if (hh > 0) { used[5] = true; lv_obj_set_height(ui::as_obj(id(hw6_s5)), hh); lv_obj_set_y(ui::as_obj(id(hw6_s5)), ybase); ybase -= hh; } }
            { const uint32_t s = h.secs(day, 7); const int hh = s ? std::max(2, (int) ((uint64_t) s * H / maxs)) : 0;
              ui::vis(id(hw6_s6), hh > 0);
              if (hh > 0) { used[6] = true; lv_obj_set_height(ui::as_obj(id(hw6_s6)), hh); lv_obj_set_y(ui::as_obj(id(hw6_s6)), ybase); ybase -= hh; } }
            { const uint32_t s = h.secs(day, 8); const int hh = s ? std::max(2, (int) ((uint64_t) s * H / maxs)) : 0;
              ui::vis(id(hw6_s7), hh > 0);
              if (hh > 0) { used[7] = true; lv_obj_set_height(ui::as_obj(id(hw6_s7)), hh); lv_obj_set_y(ui::as_obj(id(hw6_s7)), ybase); ybase -= hh; } }
          }
          ui::vis(id(hl0), used[0]); ui::text(id(hl0_n), ui::zone_name(1));
          ui::vis(id(hl1), used[1]); ui::text(id(hl1_n), ui::zone_name(2));
          ui::vis(id(hl2), used[2]); ui::text(id(hl2_n), ui::zone_name(3));
          ui::vis(id(hl3), used[3]); ui::text(id(hl3_n), ui::zone_name(4));
          ui::vis(id(hl4), used[4]); ui::text(id(hl4_n), ui::zone_name(5));
          ui::vis(id(hl5), used[5]); ui::text(id(hl5_n), ui::zone_name(6));
          ui::vis(id(hl6), used[6]); ui::text(id(hl6_n), ui::zone_name(7));
          ui::vis(id(hl7), used[7]); ui::text(id(hl7_n), ui::zone_name(8));
          // one day
          {
            const int32_t day = id(hist_day);
            const auto lt = esphome::ESPTime::from_epoch_local((time_t) (now - (long) (today - day) * 86400));
            std::string title = day == today ? std::string("Today") : day == today - 1 ? std::string("Yesterday")
                : std::string(wd[(lt.day_of_week + 6) % 7]) + ", " + mo[(lt.month + 11) % 12] + " " + std::to_string(lt.day_of_month);
            ui::text(id(hd_title), title);
            const uint32_t tot = h.secs(day, 0);
            ui::text(id(hd_total), std::to_string((tot + 59) / 60) + " min");
            ui::vis(id(hd_none), tot == 0);
            uint32_t mx = 60;
            for (int z = 1; z <= 8; z++) mx = std::max(mx, h.secs(day, z));
            { const uint32_t s = h.secs(day, 1);
              ui::vis(id(hd_r0), s > 0);
              ui::text(id(hd_r0_n), ui::zone_name(1));
              ui::text(id(hd_r0_s), h.starts(day, 1));
              lv_obj_set_width(ui::as_obj(id(hd_r0_b)), s ? std::max(3, (int) ((uint64_t) s * 150 / mx)) : 0);
              ui::text(id(hd_r0_m), std::to_string((s + 59) / 60) + " min"); }
            { const uint32_t s = h.secs(day, 2);
              ui::vis(id(hd_r1), s > 0);
              ui::text(id(hd_r1_n), ui::zone_name(2));
              ui::text(id(hd_r1_s), h.starts(day, 2));
              lv_obj_set_width(ui::as_obj(id(hd_r1_b)), s ? std::max(3, (int) ((uint64_t) s * 150 / mx)) : 0);
              ui::text(id(hd_r1_m), std::to_string((s + 59) / 60) + " min"); }
            { const uint32_t s = h.secs(day, 3);
              ui::vis(id(hd_r2), s > 0);
              ui::text(id(hd_r2_n), ui::zone_name(3));
              ui::text(id(hd_r2_s), h.starts(day, 3));
              lv_obj_set_width(ui::as_obj(id(hd_r2_b)), s ? std::max(3, (int) ((uint64_t) s * 150 / mx)) : 0);
              ui::text(id(hd_r2_m), std::to_string((s + 59) / 60) + " min"); }
            { const uint32_t s = h.secs(day, 4);
              ui::vis(id(hd_r3), s > 0);
              ui::text(id(hd_r3_n), ui::zone_name(4));
              ui::text(id(hd_r3_s), h.starts(day, 4));
              lv_obj_set_width(ui::as_obj(id(hd_r3_b)), s ? std::max(3, (int) ((uint64_t) s * 150 / mx)) : 0);
              ui::text(id(hd_r3_m), std::to_string((s + 59) / 60) + " min"); }
            { const uint32_t s = h.secs(day, 5);
              ui::vis(id(hd_r4), s > 0);
              ui::text(id(hd_r4_n), ui::zone_name(5));
              ui::text(id(hd_r4_s), h.starts(day, 5));
              lv_obj_set_width(ui::as_obj(id(hd_r4_b)), s ? std::max(3, (int) ((uint64_t) s * 150 / mx)) : 0);
              ui::text(id(hd_r4_m), std::to_string((s + 59) / 60) + " min"); }
            { const uint32_t s = h.secs(day, 6);
              ui::vis(id(hd_r5), s > 0);
              ui::text(id(hd_r5_n), ui::zone_name(6));
              ui::text(id(hd_r5_s), h.starts(day, 6));
              lv_obj_set_width(ui::as_obj(id(hd_r5_b)), s ? std::max(3, (int) ((uint64_t) s * 150 / mx)) : 0);
              ui::text(id(hd_r5_m), std::to_string((s + 59) / 60) + " min"); }
            { const uint32_t s = h.secs(day, 7);
              ui::vis(id(hd_r6), s > 0);
              ui::text(id(hd_r6_n), ui::zone_name(7));
              ui::text(id(hd_r6_s), h.starts(day, 7));
              lv_obj_set_width(ui::as_obj(id(hd_r6_b)), s ? std::max(3, (int) ((uint64_t) s * 150 / mx)) : 0);
              ui::text(id(hd_r6_m), std::to_string((s + 59) / 60) + " min"); }
            { const uint32_t s = h.secs(day, 8);
              ui::vis(id(hd_r7), s > 0);
              ui::text(id(hd_r7_n), ui::zone_name(8));
              ui::text(id(hd_r7_s), h.starts(day, 8));
              lv_obj_set_width(ui::as_obj(id(hd_r7_b)), s ? std::max(3, (int) ((uint64_t) s * 150 / mx)) : 0);
              ui::text(id(hd_r7_m), std::to_string((s + 59) / 60) + " min"); }
          }
  - id: join_wifi
    parameters:
      ssid: std::string
      password: std::string
    then:
      - lambda: |-
          ui::link().send_wifi(ssid, password);   // the A8 joins too
          ui::text(id(wf_status), "Connecting to " + ssid + "...");
          ui::fg(id(wf_status), ${muted});
      - wifi.configure:
          ssid: !lambda return ssid;
          password: !lambda return password;
          save: true
          timeout: 30s
          on_connect:
            - lambda: |-
                ui::text(id(wf_status), "Connected to " + ui::wifi_current());
                ui::fg(id(wf_status), 0x2E7D32);
          on_error:
            - lambda: |-
                ui::text(id(wf_status), "Couldn't connect - kept " + ui::wifi_current());
                ui::fg(id(wf_status), 0xB3261E);
  - id: refresh_wifi
    then:
      - lambda: |-
          auto *w = wifi::global_wifi_component;
          const std::string cur = ui::wifi_current();
          ui::text(id(wf_cur), cur.empty() ? std::string("Not connected") : cur + "   (" + std::to_string((int) w->wifi_rssi()) + " dBm)");
          auto nets = ui::wifi_networks();
          ui::vis(id(wf_n0), 0 < (int) nets.size());
          if (0 < (int) nets.size()) ui::text(id(wf_n0_l), ui::ascii(nets[0].first) + (nets[0].first == cur ? "   (connected)" : ""));
          ui::vis(id(wf_n1), 1 < (int) nets.size());
          if (1 < (int) nets.size()) ui::text(id(wf_n1_l), ui::ascii(nets[1].first) + (nets[1].first == cur ? "   (connected)" : ""));
          ui::vis(id(wf_n2), 2 < (int) nets.size());
          if (2 < (int) nets.size()) ui::text(id(wf_n2_l), ui::ascii(nets[2].first) + (nets[2].first == cur ? "   (connected)" : ""));
          ui::vis(id(wf_n3), 3 < (int) nets.size());
          if (3 < (int) nets.size()) ui::text(id(wf_n3_l), ui::ascii(nets[3].first) + (nets[3].first == cur ? "   (connected)" : ""));
          ui::vis(id(wf_n4), 4 < (int) nets.size());
          if (4 < (int) nets.size()) ui::text(id(wf_n4_l), ui::ascii(nets[4].first) + (nets[4].first == cur ? "   (connected)" : ""));
          ui::vis(id(wf_n5), 5 < (int) nets.size());
          if (5 < (int) nets.size()) ui::text(id(wf_n5_l), ui::ascii(nets[5].first) + (nets[5].first == cur ? "   (connected)" : ""));
          ui::vis(id(wf_n6), 6 < (int) nets.size());
          if (6 < (int) nets.size()) ui::text(id(wf_n6_l), ui::ascii(nets[6].first) + (nets[6].first == cur ? "   (connected)" : ""));
          ui::vis(id(wf_n7), 7 < (int) nets.size());
          if (7 < (int) nets.size()) ui::text(id(wf_n7_l), ui::ascii(nets[7].first) + (nets[7].first == cur ? "   (connected)" : ""));
  - id: rename_save
    then:
      - lambda: |-
          const std::string nm = ui::ta_text(id(rn_text));
          const std::string key = "text.zone_" + std::to_string(id(cur_zone)) + "_name";
          ESP_LOGI("ui", "Rename zone %d -> \"%s\" (%s)", id(cur_zone), nm.c_str(), key.c_str());
          ui::link().set(key, nm);
      - lvgl.widget.hide: rn_sheet
  - id: refresh_settings
    then:
      - lambda: |-
          ui::text(id(sc_pin_state), id(settings_pin_v2) == 0 ? "Default 0000 - set your own" : "Your own PIN is set");
          ui::text(id(sc_pin_set_l), "Set PIN");
          ui::vis(id(sc_pin_rm), id(settings_pin_v2) != 0);
          ui::text(id(st_wifi), ui::wifi_current().empty() ? std::string("Not connected") : ui::wifi_current());
          ui::text(id(su_z1_n), ui::zone_name(1)); ui::checked(id(su_z1), ui::zone_enabled(1));
          ui::text(id(su_z2_n), ui::zone_name(2)); ui::checked(id(su_z2), ui::zone_enabled(2));
          ui::text(id(su_z3_n), ui::zone_name(3)); ui::checked(id(su_z3), ui::zone_enabled(3));
          ui::text(id(su_z4_n), ui::zone_name(4)); ui::checked(id(su_z4), ui::zone_enabled(4));
          ui::text(id(su_z5_n), ui::zone_name(5)); ui::checked(id(su_z5), ui::zone_enabled(5));
          ui::text(id(su_z6_n), ui::zone_name(6)); ui::checked(id(su_z6), ui::zone_enabled(6));
          ui::text(id(su_z7_n), ui::zone_name(7)); ui::checked(id(su_z7), ui::zone_enabled(7));
          ui::text(id(su_z8_n), ui::zone_name(8)); ui::checked(id(su_z8), ui::zone_enabled(8));
          auto idx = [](const std::string &v, std::initializer_list<const char *> o) { int i = 0; for (auto *s : o) { if (v == s) return i; i++; } return -1; };
          ui::dd_select(id(su_rain), idx(ui::get_by_name("select", "Rain sensor input"), {"None","Input 1","Input 2","Input 3","Input 4","Input 5","Input 6","Input 7","Input 8"}));
          ui::dd_select(id(su_raintype), idx(ui::get_by_name("select", "Rain sensor type"), {"Normally closed (opens when wet)","Normally open (closes when wet)"}));
          ui::dd_select(id(su_master), idx(ui::get_by_name("select", "Master valve or pump"), {"None","Relay 1","Relay 2","Relay 3","Relay 4","Relay 5","Relay 6","Relay 7","Relay 8"}));
          ui::dd_select(id(su_water), idx(ui::get_by_name("select", "Water source"), {"Potable","Well","Reclaimed"}));
          ui::text(id(wa_rd), std::to_string(ui::num_by_name("Rain delay")));
          ui::checked(id(wa_skip), ui::link().get("switch.skip_next_run") == "1");
          ui::text(id(wa_gap), std::to_string(ui::num_by_name("Gap between zones")));
          ui::dd_select(id(wa_rules), idx(ui::get_by_name("select", "Watering rules"), {"Off","Warn","Block"}));
          ui::dd_select(id(wa_hours), idx(ui::get_by_name("text", "Watering rules no-water hours"), {"","9:00-17:00","10:00-16:00","8:00-18:00"}));
          ui::text(id(wa_max), std::to_string(ui::num_by_name("Watering rules max minutes per zone")));
          { const std::string ad = ui::get_by_name("text", "Watering rules allowed days"); const uint8_t m = ad.empty() ? 0x7f : ui::days_mask(ad);
            ui::bg(id(wa_d0), (m & 1) ? 0x2E7D32 : 0xE9EEF2); ui::fg(id(wa_d0_l), (m & 1) ? 0xFFFFFF : ${ink});
            ui::bg(id(wa_d1), (m & 2) ? 0x2E7D32 : 0xE9EEF2); ui::fg(id(wa_d1_l), (m & 2) ? 0xFFFFFF : ${ink});
            ui::bg(id(wa_d2), (m & 4) ? 0x2E7D32 : 0xE9EEF2); ui::fg(id(wa_d2_l), (m & 4) ? 0xFFFFFF : ${ink});
            ui::bg(id(wa_d3), (m & 8) ? 0x2E7D32 : 0xE9EEF2); ui::fg(id(wa_d3_l), (m & 8) ? 0xFFFFFF : ${ink});
            ui::bg(id(wa_d4), (m & 16) ? 0x2E7D32 : 0xE9EEF2); ui::fg(id(wa_d4_l), (m & 16) ? 0xFFFFFF : ${ink});
            ui::bg(id(wa_d5), (m & 32) ? 0x2E7D32 : 0xE9EEF2); ui::fg(id(wa_d5_l), (m & 32) ? 0xFFFFFF : ${ink});
            ui::bg(id(wa_d6), (m & 64) ? 0x2E7D32 : 0xE9EEF2); ui::fg(id(wa_d6_l), (m & 64) ? 0xFFFFFF : ${ink});
          }
          ui::text(id(sc_dim), std::to_string((int) id(scr_dim).state));
          ui::text(id(sc_off), std::to_string((int) id(scr_off).state));
          ui::text(id(sc_from), ui::clock12((int) id(scr_day_from).state * 60));
          ui::text(id(sc_until), ui::clock12((int) id(scr_day_until).state * 60));
          ui::text(id(sc_dayb), std::to_string((int) id(scr_day).state));
          ui::text(id(sc_nightb), std::to_string((int) id(scr_night).state));
          ui::text(id(ab_link), ui::link().up() ? "Connected" : "Not connected");
          { const std::string sv = ui::get_by_name("sensor", "Wi-Fi signal"); const float s = sv.empty() ? NAN : strtof(sv.c_str(), nullptr); ui::text(id(ab_a8wifi), std::isnan(s) ? std::string("--") : std::to_string((int) s) + " dBm"); }
          { auto *w = wifi::global_wifi_component; const bool ok = w && w->is_connected();
            ui::text(id(ab_wifi), ok ? std::to_string((int) w->wifi_rssi()) + " dBm" : std::string("Not connected"));
            std::string ip = "--"; if (ok) for (auto &a : w->wifi_sta_ip_addresses()) if (a.is_ip4()) { char b[48]; ip = a.str_to(b); break; }
            ui::text(id(ab_ip), ip); }
          { const time_t bt = App.get_build_time(); const auto t = esphome::ESPTime::from_epoch_local(bt);
            static const char *const mo[] = {"Jan","Feb","Mar","Apr","May","Jun","Jul","Aug","Sep","Oct","Nov","Dec"};
            ui::text(id(ab_fw), std::string(mo[(t.month + 11) % 12]) + " " + std::to_string(t.day_of_month) + ", " + ui::clock12(t.hour * 60 + t.minute)); }
  - id: refresh_sched
    then:
      - lambda: |-
            int shown = 0;
            ui::vis(id(pc0), ui::prog_used(0) || (id(prog_shown) & 1));
            ui::text(id(pc0_when), ui::prog_when(0));
            ui::text(id(pc0_what), ui::prog_what(0));
            ui::checked(id(pc0_sw), ui::prog_on(0));
            if (ui::prog_used(0) || (id(prog_shown) & 1)) shown++;
            ui::vis(id(pc1), ui::prog_used(1) || (id(prog_shown) & 2));
            ui::text(id(pc1_when), ui::prog_when(1));
            ui::text(id(pc1_what), ui::prog_what(1));
            ui::checked(id(pc1_sw), ui::prog_on(1));
            if (ui::prog_used(1) || (id(prog_shown) & 2)) shown++;
            ui::vis(id(pc2), ui::prog_used(2) || (id(prog_shown) & 4));
            ui::text(id(pc2_when), ui::prog_when(2));
            ui::text(id(pc2_what), ui::prog_what(2));
            ui::checked(id(pc2_sw), ui::prog_on(2));
            if (ui::prog_used(2) || (id(prog_shown) & 4)) shown++;
            ui::vis(id(pc3), ui::prog_used(3) || (id(prog_shown) & 8));
            ui::text(id(pc3_when), ui::prog_when(3));
            ui::text(id(pc3_what), ui::prog_what(3));
            ui::checked(id(pc3_sw), ui::prog_on(3));
            if (ui::prog_used(3) || (id(prog_shown) & 8)) shown++;
            ui::vis(id(sched_add), shown < 4);
            const float sa = ui::link().get_float("number.seasonal_adjust");
            ui::text(id(sa_val), std::isnan(sa) ? std::string("--") : std::to_string((int) lroundf(sa)) + "%");
  - id: refresh_prog
    then:
      - lambda: |-
            const int p = id(cur_prog);
            static const char *const L[4] = {"A", "B", "C", "D"};
            ui::text(id(pg_title), std::string("Program ") + L[p & 3]);
            ui::checked(id(pg_sw), ui::prog_on(p));
            const std::string mode = ui::prog_mode(p);
            const char *const opts[4] = {"Days of the week", "Every N days", "Odd dates", "Even dates"};
            { const bool on = mode == opts[0] || (0 == 0 && mode.empty());
              ui::bg(id(pg_m0), on ? 0x1E6091 : 0xE9EEF2); ui::fg(id(pg_m0_l), on ? 0xFFFFFF : ${ink}); }
            { const bool on = mode == opts[1] || (1 == 0 && mode.empty());
              ui::bg(id(pg_m1), on ? 0x1E6091 : 0xE9EEF2); ui::fg(id(pg_m1_l), on ? 0xFFFFFF : ${ink}); }
            { const bool on = mode == opts[2] || (2 == 0 && mode.empty());
              ui::bg(id(pg_m2), on ? 0x1E6091 : 0xE9EEF2); ui::fg(id(pg_m2_l), on ? 0xFFFFFF : ${ink}); }
            { const bool on = mode == opts[3] || (3 == 0 && mode.empty());
              ui::bg(id(pg_m3), on ? 0x1E6091 : 0xE9EEF2); ui::fg(id(pg_m3_l), on ? 0xFFFFFF : ${ink}); }
            const bool custom = mode == "Days of the week" || mode.empty();
            ui::vis(id(pg_days_row), custom);
            ui::vis(id(pg_cyc), mode == "Every N days");
            ui::text(id(pg_cyc_v), std::to_string(ui::prog_every(p)));
            ui::vis(id(pg_next), mode == "Every N days");
            { const int d = ui::prog_starts_in(p);
              ui::text(id(pg_next_v), d <= 0 ? "Today" : d == 1 ? "Tomorrow" : "In " + std::to_string(d) + " days"); }
            const uint8_t dm = ui::prog_days(p);
            ui::bg(id(pg_d0), (dm & 1) ? 0x2E7D32 : 0xE9EEF2); ui::fg(id(pg_d0_l), (dm & 1) ? 0xFFFFFF : ${ink});
            ui::bg(id(pg_d1), (dm & 2) ? 0x2E7D32 : 0xE9EEF2); ui::fg(id(pg_d1_l), (dm & 2) ? 0xFFFFFF : ${ink});
            ui::bg(id(pg_d2), (dm & 4) ? 0x2E7D32 : 0xE9EEF2); ui::fg(id(pg_d2_l), (dm & 4) ? 0xFFFFFF : ${ink});
            ui::bg(id(pg_d3), (dm & 8) ? 0x2E7D32 : 0xE9EEF2); ui::fg(id(pg_d3_l), (dm & 8) ? 0xFFFFFF : ${ink});
            ui::bg(id(pg_d4), (dm & 16) ? 0x2E7D32 : 0xE9EEF2); ui::fg(id(pg_d4_l), (dm & 16) ? 0xFFFFFF : ${ink});
            ui::bg(id(pg_d5), (dm & 32) ? 0x2E7D32 : 0xE9EEF2); ui::fg(id(pg_d5_l), (dm & 32) ? 0xFFFFFF : ${ink});
            ui::bg(id(pg_d6), (dm & 64) ? 0x2E7D32 : 0xE9EEF2); ui::fg(id(pg_d6_l), (dm & 64) ? 0xFFFFFF : ${ink});
            const auto st = ui::starts(p);
            ui::vis(id(pg_s0), 0 < (int) st.size());
            if (0 < (int) st.size()) ui::text(id(pg_s0_l), ui::clock12(st[0]) + "   x");
            ui::vis(id(pg_s1), 1 < (int) st.size());
            if (1 < (int) st.size()) ui::text(id(pg_s1_l), ui::clock12(st[1]) + "   x");
            ui::vis(id(pg_s2), 2 < (int) st.size());
            if (2 < (int) st.size()) ui::text(id(pg_s2_l), ui::clock12(st[2]) + "   x");
            ui::vis(id(pg_s3), 3 < (int) st.size());
            if (3 < (int) st.size()) ui::text(id(pg_s3_l), ui::clock12(st[3]) + "   x");
            ui::vis(id(pg_sadd), st.size() < 4);
            int total = 0;
            ui::vis(id(pg_z1), ui::zone_enabled(1));
            ui::text(id(pg_z1_n), ui::zone_name(1));
            ui::text(id(pg_z1_v), std::to_string(ui::prog_minutes(p, 1)));
            if (ui::zone_enabled(1)) total += ui::prog_minutes(p, 1);
            ui::vis(id(pg_z2), ui::zone_enabled(2));
            ui::text(id(pg_z2_n), ui::zone_name(2));
            ui::text(id(pg_z2_v), std::to_string(ui::prog_minutes(p, 2)));
            if (ui::zone_enabled(2)) total += ui::prog_minutes(p, 2);
            ui::vis(id(pg_z3), ui::zone_enabled(3));
            ui::text(id(pg_z3_n), ui::zone_name(3));
            ui::text(id(pg_z3_v), std::to_string(ui::prog_minutes(p, 3)));
            if (ui::zone_enabled(3)) total += ui::prog_minutes(p, 3);
            ui::vis(id(pg_z4), ui::zone_enabled(4));
            ui::text(id(pg_z4_n), ui::zone_name(4));
            ui::text(id(pg_z4_v), std::to_string(ui::prog_minutes(p, 4)));
            if (ui::zone_enabled(4)) total += ui::prog_minutes(p, 4);
            ui::vis(id(pg_z5), ui::zone_enabled(5));
            ui::text(id(pg_z5_n), ui::zone_name(5));
            ui::text(id(pg_z5_v), std::to_string(ui::prog_minutes(p, 5)));
            if (ui::zone_enabled(5)) total += ui::prog_minutes(p, 5);
            ui::vis(id(pg_z6), ui::zone_enabled(6));
            ui::text(id(pg_z6_n), ui::zone_name(6));
            ui::text(id(pg_z6_v), std::to_string(ui::prog_minutes(p, 6)));
            if (ui::zone_enabled(6)) total += ui::prog_minutes(p, 6);
            ui::vis(id(pg_z7), ui::zone_enabled(7));
            ui::text(id(pg_z7_n), ui::zone_name(7));
            ui::text(id(pg_z7_v), std::to_string(ui::prog_minutes(p, 7)));
            if (ui::zone_enabled(7)) total += ui::prog_minutes(p, 7);
            ui::vis(id(pg_z8), ui::zone_enabled(8));
            ui::text(id(pg_z8_n), ui::zone_name(8));
            ui::text(id(pg_z8_v), std::to_string(ui::prog_minutes(p, 8)));
            if (ui::zone_enabled(8)) total += ui::prog_minutes(p, 8);
            ui::text(id(pg_total), "Total " + std::to_string(total) + " min");
  - id: refresh_zones
    then:
      - lvgl.label.update:
          id: z1_name
          text: !lambda return ui::zone_name(1);
          text_color: !lambda 'return ui::zone_running(1) ? lv_color_hex(0xFFFFFF) : lv_color_hex(${ink});'
      - lvgl.label.update:
          id: z1_info
          text: !lambda return ui::zone_info(1, id(sntp_time).now().timestamp);
          text_color: !lambda 'return ui::zone_running(1) ? lv_color_hex(0xE8F5E9) : lv_color_hex(${muted});'
      - lvgl.widget.update:
          id: z1_btn
          bg_color: !lambda 'return ui::zone_running(1) ? lv_color_hex(0x2E7D32) : (ui::zone_enabled(1) ? lv_color_hex(0xFFFFFF) : lv_color_hex(0xDCE2E7));'
      - lvgl.label.update:
          id: z2_name
          text: !lambda return ui::zone_name(2);
          text_color: !lambda 'return ui::zone_running(2) ? lv_color_hex(0xFFFFFF) : lv_color_hex(${ink});'
      - lvgl.label.update:
          id: z2_info
          text: !lambda return ui::zone_info(2, id(sntp_time).now().timestamp);
          text_color: !lambda 'return ui::zone_running(2) ? lv_color_hex(0xE8F5E9) : lv_color_hex(${muted});'
      - lvgl.widget.update:
          id: z2_btn
          bg_color: !lambda 'return ui::zone_running(2) ? lv_color_hex(0x2E7D32) : (ui::zone_enabled(2) ? lv_color_hex(0xFFFFFF) : lv_color_hex(0xDCE2E7));'
      - lvgl.label.update:
          id: z3_name
          text: !lambda return ui::zone_name(3);
          text_color: !lambda 'return ui::zone_running(3) ? lv_color_hex(0xFFFFFF) : lv_color_hex(${ink});'
      - lvgl.label.update:
          id: z3_info
          text: !lambda return ui::zone_info(3, id(sntp_time).now().timestamp);
          text_color: !lambda 'return ui::zone_running(3) ? lv_color_hex(0xE8F5E9) : lv_color_hex(${muted});'
      - lvgl.widget.update:
          id: z3_btn
          bg_color: !lambda 'return ui::zone_running(3) ? lv_color_hex(0x2E7D32) : (ui::zone_enabled(3) ? lv_color_hex(0xFFFFFF) : lv_color_hex(0xDCE2E7));'
      - lvgl.label.update:
          id: z4_name
          text: !lambda return ui::zone_name(4);
          text_color: !lambda 'return ui::zone_running(4) ? lv_color_hex(0xFFFFFF) : lv_color_hex(${ink});'
      - lvgl.label.update:
          id: z4_info
          text: !lambda return ui::zone_info(4, id(sntp_time).now().timestamp);
          text_color: !lambda 'return ui::zone_running(4) ? lv_color_hex(0xE8F5E9) : lv_color_hex(${muted});'
      - lvgl.widget.update:
          id: z4_btn
          bg_color: !lambda 'return ui::zone_running(4) ? lv_color_hex(0x2E7D32) : (ui::zone_enabled(4) ? lv_color_hex(0xFFFFFF) : lv_color_hex(0xDCE2E7));'
      - lvgl.label.update:
          id: z5_name
          text: !lambda return ui::zone_name(5);
          text_color: !lambda 'return ui::zone_running(5) ? lv_color_hex(0xFFFFFF) : lv_color_hex(${ink});'
      - lvgl.label.update:
          id: z5_info
          text: !lambda return ui::zone_info(5, id(sntp_time).now().timestamp);
          text_color: !lambda 'return ui::zone_running(5) ? lv_color_hex(0xE8F5E9) : lv_color_hex(${muted});'
      - lvgl.widget.update:
          id: z5_btn
          bg_color: !lambda 'return ui::zone_running(5) ? lv_color_hex(0x2E7D32) : (ui::zone_enabled(5) ? lv_color_hex(0xFFFFFF) : lv_color_hex(0xDCE2E7));'
      - lvgl.label.update:
          id: z6_name
          text: !lambda return ui::zone_name(6);
          text_color: !lambda 'return ui::zone_running(6) ? lv_color_hex(0xFFFFFF) : lv_color_hex(${ink});'
      - lvgl.label.update:
          id: z6_info
          text: !lambda return ui::zone_info(6, id(sntp_time).now().timestamp);
          text_color: !lambda 'return ui::zone_running(6) ? lv_color_hex(0xE8F5E9) : lv_color_hex(${muted});'
      - lvgl.widget.update:
          id: z6_btn
          bg_color: !lambda 'return ui::zone_running(6) ? lv_color_hex(0x2E7D32) : (ui::zone_enabled(6) ? lv_color_hex(0xFFFFFF) : lv_color_hex(0xDCE2E7));'
      - lvgl.label.update:
          id: z7_name
          text: !lambda return ui::zone_name(7);
          text_color: !lambda 'return ui::zone_running(7) ? lv_color_hex(0xFFFFFF) : lv_color_hex(${ink});'
      - lvgl.label.update:
          id: z7_info
          text: !lambda return ui::zone_info(7, id(sntp_time).now().timestamp);
          text_color: !lambda 'return ui::zone_running(7) ? lv_color_hex(0xE8F5E9) : lv_color_hex(${muted});'
      - lvgl.widget.update:
          id: z7_btn
          bg_color: !lambda 'return ui::zone_running(7) ? lv_color_hex(0x2E7D32) : (ui::zone_enabled(7) ? lv_color_hex(0xFFFFFF) : lv_color_hex(0xDCE2E7));'
      - lvgl.label.update:
          id: z8_name
          text: !lambda return ui::zone_name(8);
          text_color: !lambda 'return ui::zone_running(8) ? lv_color_hex(0xFFFFFF) : lv_color_hex(${ink});'
      - lvgl.label.update:
          id: z8_info
          text: !lambda return ui::zone_info(8, id(sntp_time).now().timestamp);
          text_color: !lambda 'return ui::zone_running(8) ? lv_color_hex(0xE8F5E9) : lv_color_hex(${muted});'
      - lvgl.widget.update:
          id: z8_btn
          bg_color: !lambda 'return ui::zone_running(8) ? lv_color_hex(0x2E7D32) : (ui::zone_enabled(8) ? lv_color_hex(0xFFFFFF) : lv_color_hex(0xDCE2E7));'
      - if:
          condition:
            lambda: return ui::any_running();
          then:
            - lvgl.widget.show: zones_stop
          else:
            - lvgl.widget.hide: zones_stop
  - id: refresh_zone
    then:
      - lvgl.label.update:
          id: zd_title
          text: !lambda return ui::zone_name(id(cur_zone));
      - lvgl.label.update:
          id: zs_title
          text: !lambda return ui::zone_name(id(cur_zone)) + " settings";
      - lvgl.label.update:
          id: zd_last
          text: !lambda |-
            if (ui::zone_running(id(cur_zone))) return std::string("");
            return ui::zone_info(id(cur_zone), id(sntp_time).now().timestamp);
      - lvgl.label.update:
          id: zd_head
          text: !lambda 'return ui::zone_running(id(cur_zone)) ? std::string("Watering") : std::string("Run by hand for");'
      - lvgl.label.update:
          id: zd_min
          text: !lambda |-
            if (ui::zone_running(id(cur_zone)) && ui::link().seconds_left() > 0)
              return ui::mmss(ui::link().seconds_left());
            return std::to_string(id(run_min));
      - lvgl.label.update:
          id: zd_unit
          text: !lambda 'return ui::zone_running(id(cur_zone)) ? std::string("left") : std::string("minutes");'
      - if:
          condition:
            lambda: return ui::zone_running(id(cur_zone));
          then:
            - lvgl.widget.hide: [zd_minus, zd_plus]
          else:
            - lvgl.widget.show: [zd_minus, zd_plus]
      - lvgl.label.update:
          id: zd_run_label
          text: !lambda 'return ui::zone_running(id(cur_zone)) ? std::string("Stop") : std::string("Run");'
      - lvgl.widget.update:
          id: zd_run
          bg_color: !lambda 'return ui::zone_running(id(cur_zone)) ? lv_color_hex(0xB3261E) : lv_color_hex(0x2E7D32);'
      - lvgl.widget.update:
          id: zd_enabled
          state:
            checked: !lambda return ui::zone_enabled(id(cur_zone));
      - lvgl.label.update:
          id: zd_max
          text: !lambda return std::to_string(ui::zone_number(id(cur_zone), "_max_minutes"));
      - lvgl.label.update:
          id: zd_cycle
          text: !lambda return std::to_string(ui::zone_number(id(cur_zone), "_cycle_minutes"));
      - lvgl.label.update:
          id: zd_soak
          text: !lambda return std::to_string(ui::zone_number(id(cur_zone), "_soak_minutes"));
  # Home's live status, from the A8's mirrored entities.
  - id: refresh_home
    then:
      - lvgl.label.update:
          id: link_icon
          text: !lambda 'return a8link::client().up() ? std::string("\U000F0339") : std::string("\U000F033A");'
          text_color: !lambda 'return a8link::client().up() ? lv_color_hex(0x2E7D32) : lv_color_hex(0xB3261E);'
      - lambda: |-
          // Quick actions sheet
          {
            const float rdq = ui::link().get_float("number.rain_delay");
            ui::vis(id(qs_clear), !std::isnan(rdq) && rdq > 0);
            ui::text(id(qs_skip_l), ui::link().get("switch.skip_next_run") == "1" ? "Don't skip the next run" : "Skip next run");
          }
          // Flow box: only once the A8 has a flow sensor (layout checked with mock values 2026-11-05)
          ui::vis(id(flow_panel), !ui::link().get("sensor.flow_rate").empty());
          // Wi-Fi icon from the real state (the connect event can fire before the display is up)
          const bool wifi_ok = wifi::global_wifi_component != nullptr && wifi::global_wifi_component->is_connected();
          ui::text(id(wifi_icon), wifi_ok ? "\U000F05A9" : "\U000F05AA");
          ui::fg(id(wifi_icon), wifi_ok ? 0x2E7D32 : 0xB3261E);
          auto &l = a8link::client();
          const long now = id(sntp_time).now().timestamp;
          if (!l.up()) {
            ui::text(id(status), "Offline");
            ui::text(id(status_icon), "\U000F05D6");
            ui::fg(id(status), 0xB3261E); ui::fg(id(status_icon), 0xB3261E); ui::bg(id(status_pill), 0xFBE9E7);
            ui::text(id(next_head), "CONTROLLER");
            ui::text(id(next), "--");
            ui::text(id(next_day), "Check the cable to the controller");
          } else if (!ui::running_zone().empty()) {
            ui::text(id(status), "Running");
            ui::text(id(status_icon), "\U000F1060");
            ui::fg(id(status), 0x2E7D32); ui::fg(id(status_icon), 0x2E7D32); ui::bg(id(status_pill), 0xE8F5E9);
            ui::text(id(next_head), "WATERING");
            const long left = l.seconds_left();
            ui::text(id(next), left > 0 ? ui::mmss(left) : std::string("--"));
            ui::text(id(next_day), ui::running_zone());
          } else {
            // Idle, with an icon for what the garden is doing
            const float rd = l.get_float("number.rain_delay");
            if (!std::isnan(rd) && rd > 0) {
              ui::text(id(status), "Rain delay");
              ui::text(id(status_icon), "\U000F054A");
              ui::fg(id(status), 0x1E6091); ui::fg(id(status_icon), 0x1E6091); ui::bg(id(status_pill), 0xE3EEF7);
            } else if (l.get("switch.skip_next_run") == "1") {
              ui::text(id(status), "Skipping");
              ui::text(id(status_icon), "\U000F0662");
              ui::fg(id(status), 0x1E6091); ui::fg(id(status_icon), 0x1E6091); ui::bg(id(status_pill), 0xE3EEF7);
            } else if (id(is_daytime)()) {
              ui::text(id(status), "Idle");
              ui::text(id(status_icon), "\U000F0E66");
              ui::fg(id(status), ${muted}); ui::fg(id(status_icon), 0x2E7D32); ui::bg(id(status_pill), 0xE9F3EA);
            } else {
              ui::text(id(status), "Idle");
              ui::text(id(status_icon), "\U000F0594");
              ui::fg(id(status), ${muted}); ui::fg(id(status_icon), 0x4A4E8C); ui::bg(id(status_pill), 0xECEDF6);
            }
            ui::text(id(next_head), "NEXT RUN");
            const std::string n = l.get("text_sensor.next_run");
            ui::text(id(next), n.empty() ? std::string("Set one up in Schedule") : ui::when_time(n));
            ui::text(id(next_day), n.empty() ? std::string("No runs set") : ui::when_day(n, now));
          }
      - lvgl.label.update:
          id: badges
          text: !lambda |-
            auto &l = a8link::client();
            std::string b;
            const float rd = l.get_float("number.rain_delay");
            if (!std::isnan(rd) && rd > 0) b += "Rain delay " + std::to_string((int) rd) + (rd == 1 ? " day" : " days");
            if (l.get("switch.skip_next_run") == "1") b += std::string(b.empty() ? "" : "   ") + "Skipping next run";
            return b;
  - id: update_clock   # "Wed, Nov 5   7:42 PM" (built by hand: no %-I in the ESP32's C library)
    then:
      - lvgl.label.update:
          id: clock_label
          text: !lambda |-
            auto t = id(sntp_time).now();
            if (!t.is_valid()) return std::string("");
            static const char *const days[] = {"Sun", "Mon", "Tue", "Wed", "Thu", "Fri", "Sat"};
            static const char *const months[] = {"Jan", "Feb", "Mar", "Apr", "May", "Jun",
                                                 "Jul", "Aug", "Sep", "Oct", "Nov", "Dec"};
            int h = t.hour % 12;
            char buf[40];
            snprintf(buf, sizeof(buf), "%s, %s %d     %d:%02d %s", days[(t.day_of_week + 6) % 7],
                     months[(t.month + 11) % 12], t.day_of_month, h == 0 ? 12 : h, t.minute, t.hour < 12 ? "AM" : "PM");
            return std::string(buf);
  - id: apply_brightness
    mode: restart
    then:
      - light.turn_on:
          id: backlight
          transition_length: 0s
          brightness: !lambda |-
            float lvl = id(sliding) ? id(slide_val) : (id(is_daytime)() ? id(scr_day).state : id(scr_night).state);
            if (id(screen_state) == 1) lvl /= 3;
            return std::max(0.03f, lvl / 100.0f);
      - lvgl.label.update:
          id: bright_tag
          text: !lambda |-
            static char buf[24];
            snprintf(buf, sizeof(buf), "Brightness %d%%", (int) (id(sliding) ? id(slide_val) : (id(is_daytime)() ? id(scr_day).state : id(scr_night).state)));
            return buf;

number:
  # The screen's own settings (Settings > Screen on the screen, or here in HA).
  - platform: template
    id: scr_dim
    on_value:
      - script.execute: refresh_settings
      - script.execute: apply_brightness
    name: "Dim after"
    entity_category: config
    optimistic: true
    restore_value: true
    min_value: 10
    max_value: 600
    step: 5
    initial_value: ${dim_after}
    unit_of_measurement: "s"
  - platform: template
    id: scr_off
    on_value:
      - script.execute: refresh_settings
      - script.execute: apply_brightness
    name: "Off after"
    entity_category: config
    optimistic: true
    restore_value: true
    min_value: 15
    max_value: 1800
    step: 15
    initial_value: ${off_after}
    unit_of_measurement: "s"
  - platform: template
    id: scr_day_from
    on_value:
      - script.execute: refresh_settings
      - script.execute: apply_brightness
    name: "Day starts"
    entity_category: config
    optimistic: true
    restore_value: true
    min_value: 0
    max_value: 23
    step: 1
    initial_value: ${day_from}
    unit_of_measurement: "h"
  - platform: template
    id: scr_day_until
    on_value:
      - script.execute: refresh_settings
      - script.execute: apply_brightness
    name: "Day ends"
    entity_category: config
    optimistic: true
    restore_value: true
    min_value: 0
    max_value: 23
    step: 1
    initial_value: ${day_until}
    unit_of_measurement: "h"
  - platform: template
    id: scr_day
    on_value:
      - script.execute: refresh_settings
      - script.execute: apply_brightness
    name: "Day brightness"
    entity_category: config
    optimistic: true
    restore_value: true
    min_value: 5
    max_value: 100
    step: 1
    initial_value: 70
    unit_of_measurement: "%"
  - platform: template
    id: scr_night
    on_value:
      - script.execute: refresh_settings
      - script.execute: apply_brightness
    name: "Night brightness"
    entity_category: config
    optimistic: true
    restore_value: true
    min_value: 5
    max_value: 100
    step: 1
    initial_value: 30
    unit_of_measurement: "%"

output:
  - platform: gpio
    id: amp_off
    pin: GPIO1
  - platform: ledc
    id: backlight_pwm
    pin: GPIO41

light:
  - platform: monochromatic
    id: backlight
    name: Backlight
    output: backlight_pwm
    restore_mode: ALWAYS_ON
    default_transition_length: 250ms

external_components:
  - source:
      type: local
      path: components
    components: [st77922_qspi]

display:
  # ESPHome's mipi_spi woke the panel but never showed an image; this driver uses Espressif's
  # esp_lcd_st77922 with the seller's own init table (both needed), and resets the whole chip on
  # GPIO48 first (it resets display AND touch, so the touchscreen below must not have a reset pin).
  - platform: st77922_qspi
    id: lcd
    dimensions:
      width: 320
      height: 480
    reset_pin: GPIO48
    te_pin: GPIO42      # tearing effect (LCD_TE): writes wait for it
    cs_pin: GPIO10
    clk_pin: GPIO12
    data_pins: [GPIO11, GPIO13, GPIO14, GPIO9]
    update_interval: never

i2c:
  - id: touch_i2c
    sda: GPIO38
    scl: GPIO39
    scan: true
    frequency: 400kHz

touchscreen:
  - platform: st7123
    id: touch
    i2c_id: touch_i2c
    address: 0x55
    interrupt_pin: GPIO47
    on_touch:
      - if:
          condition:
            lambda: return id(screen_state) != 0;
          then:
            - lambda: id(screen_state) = 0;
            - lvgl.resume:
            - script.execute: apply_brightness

font:
  # Material Design Icons (Apache 2.0): only the glyphs used here are built in.
  - file: "https://raw.githubusercontent.com/Templarian/MaterialDesign-Webfont/master/fonts/materialdesignicons-webfont.ttf"
    id: icons_40
    size: 40
    glyphs:
      - "\U000F1060"   # sprinkler-variant  (Zones)
      - "\U000F00F0"   # calendar-clock     (Schedule)
      - "\U000F0128"   # chart-bar          (History)
      - "\U000F0493"   # cog                (Settings)
  - file: "https://raw.githubusercontent.com/Templarian/MaterialDesign-Webfont/master/fonts/materialdesignicons-webfont.ttf"
    id: icons_28
    size: 28
    glyphs:
      - "\U000F0141"   # chevron-left (back)
      - "\U000F054A"   # umbrella     (rain delay)
      - "\U000F04AD"   # skip-next
      - "\U000F04DB"   # stop
      - "\U000F0493"   # cog (zone settings)
      - "\U000F03EB"   # pencil (rename)
      - "\U000F0156"   # close
      - "\U000F00DF"   # brightness-6        (Settings > Screen)
      - "\U000F02FD"   # information-outline (Settings > About)
      - "\U000F05A9"   # wifi                (Settings > Wi-Fi)
  - file: "https://raw.githubusercontent.com/Templarian/MaterialDesign-Webfont/master/fonts/materialdesignicons-webfont.ttf"
    id: icons_20
    size: 20
    glyphs:
      - "\U000F05A9"   # wifi
      - "\U000F05AA"   # wifi-off
      - "\U000F0339"   # link-variant      (A8 link up)
      - "\U000F033A"   # link-variant-off  (A8 link down)
      - "\U000F058C"   # water             (flow)
      - "\U000F185A"   # waves-arrow-right (flow panel)
      - "\U000F0E66"   # sprout               (idle, day)
      - "\U000F0594"   # weather-night        (idle, night)
      - "\U000F054A"   # umbrella             (rain delay)
      - "\U000F0662"   # skip-next-circle-outline (skipping)
      - "\U000F1060"   # sprinkler-variant    (running)
      - "\U000F05D6"   # alert-circle-outline (offline)

lvgl:
  displays: [lcd]
  touchscreens: [touch]
  rotation: 90
  buffer_size: 25%
  on_idle:
    - timeout: !lambda return (uint32_t) (id(scr_dim).state * 1000);
      then:
        - lambda: id(screen_state) = 1;
        - script.execute: apply_brightness
    - timeout: !lambda return (uint32_t) (id(scr_off).state * 1000);
      then:
        - lambda: |-
            id(screen_state) = 2;
            id(settings_unlocked) = false;
        - light.turn_off: {id: backlight, transition_length: 1s}
        - lvgl.pause:
            show_snow: false
  theme:
    label:
      text_color: ${ink}
  style_definitions:
    - id: page_style
      bg_color: ${paper}
      pad_top: 12
      pad_bottom: 12
      pad_right: 14
      pad_left: !lambda return ${bezel_left} + 14;
    - id: card_style
      bg_color: 0xFFFFFF
      border_width: 0
      radius: 14
      pad_all: 14
      shadow_width: 0
    - id: app_btn
      radius: 40
      width: 80
      height: 80
      shadow_width: 0
    - id: back_btn
      bg_opa: TRANSP
      shadow_width: 0
      width: 44
      height: 40
      pad_all: 0

  # On every page: the black left bezel (the panel's picture is off-centre in its glass, so this
  # balances the black edge at the top and right) doubles as a hidden brightness control.
  top_layer:
    widgets:
      - obj:
          id: bezel_strip
          x: 0
          y: 0
          width: ${bezel_left}
          height: 100%
          bg_color: 0x000000
          border_width: 0
          radius: 0
          scrollable: false
          on_press:
            - lambda: |-
                id(slide_last_y) = point.y;
                id(slide_val) = id(is_daytime)() ? id(scr_day).state : id(scr_night).state;
                id(sliding) = true;
            - lvgl.widget.show: bright_tag
          on_pressing:
            - lambda: |-
                int dy = id(slide_last_y) - point.y;   // up = positive
                if (dy == 0) return;
                id(slide_last_y) = point.y;
                id(slide_val) = std::max(5.0f, std::min(100.0f, id(slide_val) + dy * 0.35f));
            - script.execute: apply_brightness
          on_release:
            - lambda: |-
                if (!id(sliding)) return;
                id(sliding) = false;
                auto *n = id(is_daytime)() ? id(scr_day) : id(scr_night);
                auto c = n->make_call();
                c.set_value(roundf(id(slide_val)));
                c.perform();
            - delay: 1500ms
            - lvgl.widget.hide: bright_tag
      # Rename a zone: a popup with a text box and keyboard (the name lives on the A8, so HA sees it)
      - obj:
          id: rn_sheet
          hidden: true
          x: ${bezel_left}
          y: 0
          width: !lambda return 480 - ${bezel_left};
          height: 320
          bg_color: ${paper}
          border_width: 0
          radius: 0
          pad_all: 10
          scrollable: false
          widgets:
            - label:
                id: rn_title
                align: TOP_LEFT
                y: 10
                text_font: montserrat_20
                text: "Rename zone"
            - textarea:
                id: rn_text
                align: TOP_LEFT
                y: 40
                width: 250
                height: 44
                one_line: true
                max_length: 20
                text_font: montserrat_20
                placeholder_text: "Zone name"
            - button:
                align: TOP_RIGHT
                x: -86
                y: 40
                width: 80
                height: 44
                radius: 10
                bg_color: 0xE9EEF2
                shadow_width: 0
                on_click:
                  - lvgl.widget.hide: rn_sheet
                widgets: [{label: {align: CENTER, text_font: montserrat_18, text: "Cancel"}}]
            - button:
                align: TOP_RIGHT
                y: 40
                width: 80
                height: 44
                radius: 10
                bg_color: 0x2E7D32
                shadow_width: 0
                on_click:
                  - script.execute: rename_save
                widgets: [{label: {align: CENTER, text_font: montserrat_18, text_color: 0xFFFFFF, text: "Save"}}]
            - keyboard:
                id: rn_kb
                textarea: rn_text
                mode: TEXT_LOWER
                align: BOTTOM_MID
                width: 100%
                height: 210
                on_ready:
                  - script.execute: rename_save
                on_cancel:
                  - lvgl.widget.hide: rn_sheet
      # Join a network: name (only for "Other network"), password, keyboard.
      - obj:
          id: wf_sheet
          hidden: true
          x: ${bezel_left}
          y: 0
          width: !lambda return 480 - ${bezel_left};
          height: 320
          bg_color: ${paper}
          border_width: 0
          radius: 0
          pad_all: 10
          scrollable: false
          widgets:
            - label: {id: wf_title, align: TOP_LEFT, y: 4, text_font: montserrat_20, text: "Join"}
            - textarea:
                id: wf_ssid_ta
                hidden: true
                align: TOP_RIGHT
                y: 0
                width: 220
                height: 36
                one_line: true
                max_length: 32
                text_font: montserrat_16
                placeholder_text: "Network name"
                on_focus:
                  - lambda: lv_keyboard_set_textarea(ui::as_obj(id(wf_kb)), ui::as_obj(id(wf_ssid_ta)));
            - textarea:
                id: wf_pw
                align: TOP_LEFT
                y: 44
                width: 200
                height: 40
                one_line: true
                password_mode: true
                max_length: 64
                text_font: montserrat_18
                placeholder_text: "Password"
                on_focus:
                  - lambda: lv_keyboard_set_textarea(ui::as_obj(id(wf_kb)), ui::as_obj(id(wf_pw)));
            - button:
                align: TOP_LEFT
                x: 206
                y: 44
                width: 56
                height: 40
                radius: 10
                bg_color: 0xE9EEF2
                shadow_width: 0
                on_click:
                  - lambda: lv_textarea_set_password_mode(ui::as_obj(id(wf_pw)), !lv_textarea_get_password_mode(ui::as_obj(id(wf_pw))));
                widgets: [{label: {align: CENTER, text_font: montserrat_14, text: "Show"}}]
            - button:
                align: TOP_RIGHT
                x: -84
                y: 44
                width: 76
                height: 40
                radius: 10
                bg_color: 0xE9EEF2
                shadow_width: 0
                on_click: [lvgl.widget.hide: wf_sheet]
                widgets: [{label: {align: CENTER, text_font: montserrat_16, text: "Cancel"}}]
            - button:
                align: TOP_RIGHT
                y: 44
                width: 80
                height: 40
                radius: 10
                bg_color: 0x2E7D32
                shadow_width: 0
                on_click:
                  - lambda: |-
                      std::string ssid = id(wf_ssid).empty() ? ui::ta_text(id(wf_ssid_ta)) : id(wf_ssid);
                      if (ssid.empty()) return;
                      id(join_wifi).execute(ssid, ui::ta_text(id(wf_pw)));
                  - lvgl.widget.hide: wf_sheet
                widgets: [{label: {align: CENTER, text_font: montserrat_16, text_color: 0xFFFFFF, text: "Connect"}}]
            - keyboard:
                id: wf_kb
                textarea: wf_pw
                mode: TEXT_LOWER
                align: BOTTOM_MID
                width: 100%
                height: 214
                on_cancel: [lvgl.widget.hide: wf_sheet]
      # Settings PIN keypad
      - obj:
          id: pin_sheet
          hidden: true
          x: ${bezel_left}
          y: 0
          width: !lambda return 480 - ${bezel_left};
          height: 320
          bg_color: ${paper}
          border_width: 0
          radius: 0
          pad_all: 10
          scrollable: false
          widgets:
            - label: {id: pin_title, align: TOP_LEFT, y: 6, text_font: montserrat_20, text: "Enter PIN"}
            - label: {id: pin_dots, align: TOP_LEFT, y: 40, text_font: montserrat_28, text: ""}
            - label: {id: pin_msg, align: TOP_LEFT, y: 84, width: 120, long_mode: WRAP, text_color: 0xB3261E, text_font: montserrat_14, text: ""}
            - button:
                align: BOTTOM_LEFT
                width: 110
                height: 44
                radius: 10
                bg_color: 0xE9EEF2
                shadow_width: 0
                on_click: [lvgl.widget.hide: pin_sheet]
                widgets: [{label: {align: CENTER, text_font: montserrat_16, text: "Cancel"}}]
            - obj:
                align: RIGHT_MID
                width: 280
                height: 196
                bg_opa: TRANSP
                border_width: 0
                pad_all: 0
                scrollable: false
                widgets:
                  - button:
                      x: 0
                      y: 0
                      width: 88
                      height: 44
                      radius: 10
                      bg_color: 0xFFFFFF
                      shadow_width: 0
                      on_click:
                        - lambda: 'if (id(pin_buf).size() < 4) id(pin_buf) += "1";'
                        - script.execute: pin_entered
                      widgets: [{label: {align: CENTER, text_font: montserrat_22, text: "1"}}]

                  - button:
                      x: 96
                      y: 0
                      width: 88
                      height: 44
                      radius: 10
                      bg_color: 0xFFFFFF
                      shadow_width: 0
                      on_click:
                        - lambda: 'if (id(pin_buf).size() < 4) id(pin_buf) += "2";'
                        - script.execute: pin_entered
                      widgets: [{label: {align: CENTER, text_font: montserrat_22, text: "2"}}]

                  - button:
                      x: 192
                      y: 0
                      width: 88
                      height: 44
                      radius: 10
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
                      shadow_width: 0
                      on_click:
                        - lambda: 'id(pin_buf) = "";'
                        - script.execute: pin_entered
                      widgets: [{label: {align: CENTER, text_font: montserrat_16, text: "Clear"}}]

                  - button:
                      x: 96
                      y: 150
                      width: 88
                      height: 44
                      radius: 10
                      bg_color: 0xFFFFFF
                      shadow_width: 0
                      on_click:
                        - lambda: 'if (id(pin_buf).size() < 4) id(pin_buf) += "0";'
                        - script.execute: pin_entered
                      widgets: [{label: {align: CENTER, text_font: montserrat_22, text: "0"}}]

                  - button:
                      x: 192
                      y: 150
                      width: 88
                      height: 44
                      radius: 10
                      bg_color: 0xFFFFFF
                      shadow_width: 0
                      on_click:
                        - lambda: 'if (!id(pin_buf).empty()) id(pin_buf).pop_back();'
                        - script.execute: pin_entered
                      widgets: [{label: {align: CENTER, text_font: montserrat_16, text: "Del"}}]
      - label:
          id: bright_tag
          align: TOP_MID
          y: 4
          hidden: true
          bg_color: 0x1B2733
          bg_opa: 85%
          radius: 10
          pad_left: 12
          pad_right: 12
          pad_top: 4
          pad_bottom: 4
          text_color: 0xFFFFFF
          text_font: montserrat_16
          text: "Brightness"

  pages:
    # ── Home: status on top, the four apps below (a launcher, no tabs) ──
    - id: home_page
      styles: page_style
      scrollable: false
      widgets:
        # Top row: the time, and the A8-link / Wi-Fi state (no title: it's on the irrigation box).
        - label:
            id: clock_label
            align: TOP_LEFT
            text_font: montserrat_20
            text: ""
        - label:
            id: link_icon
            align: TOP_RIGHT
            x: -30
            y: 2
            text_font: icons_20
            text_color: 0xB3261E
            text: "\U000F033A"
        - label:
            id: wifi_icon
            align: TOP_RIGHT
            y: 2
            text_font: icons_20
            text_color: ${muted}
            text: "\U000F05AA"
        - obj:
            id: card
            styles: card_style
            align: TOP_MID
            y: 32
            width: 100%
            height: 140
            scrollable: false
            widgets:
              - label:
                  id: next_head
                  align: TOP_LEFT
                  text_color: ${muted}
                  text_font: montserrat_14
                  text: "NEXT RUN"
              - obj:
                  id: status_pill
                  on_click:
                    - lvgl.widget.show: quick_sheet
                  align: TOP_RIGHT
                  width: SIZE_CONTENT
                  height: SIZE_CONTENT
                  bg_color: 0xE9EEF2
                  border_width: 0
                  radius: 12
                  pad_left: 8
                  pad_right: 10
                  pad_top: 3
                  pad_bottom: 3
                  scrollable: false
                  layout:
                    type: FLEX
                    flex_flow: ROW
                    flex_align_cross: CENTER
                    pad_column: 5
                  widgets:
                    - label:
                        id: status_icon
                        text_font: icons_20
                        text_color: ${muted}
                        text: "\U000F0E66"
                    - label:
                        id: status
                        text_color: ${muted}
                        text_font: montserrat_16
                        text: "Idle"
              - label:
                  id: next
                  align: TOP_LEFT
                  y: 62
                  text_color: ${muted}
                  text_font: montserrat_20
                  text: "--"
              - label:
                  id: next_day
                  align: TOP_LEFT
                  y: 20
                  text_font: montserrat_32
                  width: 250
                  long_mode: DOT
                  text: ""
              - label:
                  id: badges
                  align: BOTTOM_LEFT
                  text_color: 0x1E6091
                  text_font: montserrat_16
                  text: ""
              # Flow, under the status pill, in its own light-blue box: live rate and today's
              # total once a sensor is set up ("Not fitted" until then).
              - obj:
                  id: flow_panel
                  hidden: true   # shown once a flow sensor is set up on the A8
                  align: TOP_RIGHT
                  y: 32
                  width: 136
                  height: 76
                  bg_color: 0xCFE2F3
                  border_width: 0
                  radius: 10
                  pad_all: 8
                  scrollable: false
                  widgets:
                    - label:
                        align: TOP_RIGHT
                        x: -40
                        text_font: icons_20
                        text_color: 0x1E6091
                        text: "\U000F185A"
                    - label:
                        align: TOP_RIGHT
                        y: 2
                        text_color: 0x1E6091
                        text_font: montserrat_14
                        text: "Flow"
                    - label:
                        id: flow_now
                        align: TOP_RIGHT
                        y: 20
                        text_font: montserrat_20
                        text: "--"
                    - label:
                        id: flow_today
                        align: TOP_RIGHT
                        y: 44
                        text_color: ${muted}
                        text_font: montserrat_14
                        text: ""
        - obj:
            id: apps_row
            align: BOTTOM_MID
            width: 100%
            height: 118
            bg_opa: TRANSP
            border_width: 0
            pad_all: 0
            scrollable: false
            layout:
              type: FLEX
              flex_flow: ROW
              flex_align_main: SPACE_EVENLY
              flex_align_cross: START
            widgets:
              - obj: &app
                  bg_opa: TRANSP
                  border_width: 0
                  pad_all: 0
                  width: 92
                  height: 118
                  scrollable: false
                  widgets:
                    - button:
                        styles: app_btn
                        align: TOP_MID
                        bg_color: 0x2E7D32
                        on_click: {lvgl.page.show: {id: zones_page, animation: MOVE_LEFT, time: 180ms}}
                        widgets: [{label: {align: CENTER, text_font: icons_40, text_color: 0xFFFFFF, text: "\U000F1060"}}]
                    - label: {align: BOTTOM_MID, text_font: montserrat_16, text: "Zones"}
              - obj:
                  <<: *app
                  widgets:
                    - button:
                        styles: app_btn
                        align: TOP_MID
                        bg_color: 0x1E6091
                        on_click: {lvgl.page.show: {id: schedule_page, animation: MOVE_LEFT, time: 180ms}}
                        widgets: [{label: {align: CENTER, text_font: icons_40, text_color: 0xFFFFFF, text: "\U000F00F0"}}]
                    - label: {align: BOTTOM_MID, text_font: montserrat_16, text: "Schedule"}
              - obj:
                  <<: *app
                  widgets:
                    - button:
                        styles: app_btn
                        align: TOP_MID
                        bg_color: 0x6A4C93
                        on_click:
                          - lambda: id(hist_view) = 0;
                          - script.execute: refresh_history
                          - lvgl.page.show: {id: history_page, animation: MOVE_LEFT, time: 180ms}
                        widgets: [{label: {align: CENTER, text_font: icons_40, text_color: 0xFFFFFF, text: "\U000F0128"}}]
                    - label: {align: BOTTOM_MID, text_font: montserrat_16, text: "History"}
              - obj:
                  <<: *app
                  widgets:
                    - button:
                        styles: app_btn
                        align: TOP_MID
                        bg_color: 0x5B6B78
                        on_click:
                          - if:
                              condition:
                                lambda: return id(settings_unlocked);
                              then:
                                - script.execute: refresh_settings
                                - lvgl.page.show: {id: settings_page, animation: MOVE_LEFT, time: 180ms}
                              else:
                                - lambda: |-
                                    id(pin_mode) = 0;
                                    id(pin_buf) = "";
                                - script.execute: pin_show
                        widgets: [{label: {align: CENTER, text_font: icons_40, text_color: 0xFFFFFF, text: "\U000F0493"}}]
                    - label: {align: BOTTOM_MID, text_font: montserrat_16, text: "Settings"}
        # Quick actions (tap the status pill): rain delay and skip next run.
        - obj:
            id: quick_sheet
            hidden: true
            align: CENTER
            width: 330
            height: SIZE_CONTENT
            bg_color: 0xFFFFFF
            radius: 16
            border_width: 0
            shadow_width: 30
            shadow_opa: 40%
            pad_all: 14
            scrollable: false
            layout:
              type: FLEX
              flex_flow: COLUMN
              pad_row: 8
            widgets:
              - obj:
                  width: 100%
                  height: 30
                  bg_opa: TRANSP
                  border_width: 0
                  pad_all: 0
                  scrollable: false
                  widgets:
                    - label: {align: LEFT_MID, text_font: montserrat_20, text: "Quick actions"}
                    - button:
                        align: RIGHT_MID
                        width: 36
                        height: 30
                        bg_opa: TRANSP
                        shadow_width: 0
                        on_click: [lvgl.widget.hide: quick_sheet]
                        widgets: [{label: {align: CENTER, text_font: icons_28, text_color: "${muted}", text: "\U000F0156"}}]
              - button:
                  width: 100%
                  height: 40
                  radius: 10
                  bg_color: 0xE3EEF7
                  shadow_width: 0
                  on_click:
                    - lambda: |-
                        ui::link().set("number.rain_delay", "1");
                    - lvgl.widget.hide: quick_sheet
                  widgets:
                    - label:
                        align: CENTER
                        text_font: montserrat_18
                        text_color: 0x1E6091
                        text: "Rain delay 1 day"
              - button:
                  width: 100%
                  height: 40
                  radius: 10
                  bg_color: 0xE3EEF7
                  shadow_width: 0
                  on_click:
                    - lambda: |-
                        ui::link().set("number.rain_delay", "3");
                    - lvgl.widget.hide: quick_sheet
                  widgets:
                    - label:
                        align: CENTER
                        text_font: montserrat_18
                        text_color: 0x1E6091
                        text: "Rain delay 3 days"
              - button:
                  id: qs_clear
                  width: 100%
                  height: 40
                  radius: 10
                  bg_color: 0xE3EEF7
                  shadow_width: 0
                  on_click:
                    - lambda: |-
                        ui::link().set("number.rain_delay", "0");
                    - lvgl.widget.hide: quick_sheet
                  widgets:
                    - label:
                        id: qs_clear_l
                        align: CENTER
                        text_font: montserrat_18
                        text_color: 0x1E6091
                        text: "Clear rain delay"
              - button:
                  id: qs_skip
                  width: 100%
                  height: 40
                  radius: 10
                  bg_color: 0xE3EEF7
                  shadow_width: 0
                  on_click:
                    - lambda: |-
                        ui::link().set("switch.skip_next_run", ui::link().get("switch.skip_next_run") == "1" ? "0" : "1");
                    - lvgl.widget.hide: quick_sheet
                  widgets:
                    - label:
                        id: qs_skip_l
                        align: CENTER
                        text_font: montserrat_18
                        text_color: 0x1E6091
                        text: "Skip next run"

    # ── Zones: the 8 zones as tiles; tap one to run it or change its settings ──
    - id: zones_page
      styles: page_style
      scrollable: false
      on_swipe_right:
        - lvgl.page.show: {id: home_page, animation: MOVE_RIGHT, time: 180ms}
      widgets:
        - button:
            styles: back_btn
            align: TOP_LEFT
            x: -8
            on_click: {lvgl.page.show: {id: home_page, animation: MOVE_RIGHT, time: 180ms}}
            widgets:
              - label:
                  align: CENTER
                  text_font: icons_28
                  text_color: ${ink}
                  text: "\U000F0141"
        - label: {align: TOP_LEFT, x: 40, y: 4, text_font: montserrat_24, text: "Zones"}
        - button:
            id: zones_stop
            align: TOP_RIGHT
            hidden: true
            width: 110
            height: 38
            radius: 10
            bg_color: 0xB3261E
            shadow_width: 0
            on_click:
              - lambda: ui::link().press("button.stop");
            widgets: [{label: {align: CENTER, text_font: montserrat_18, text_color: 0xFFFFFF, text: "Stop all"}}]
        - obj:
            align: BOTTOM_MID
            width: 100%
            height: 248
            bg_opa: TRANSP
            border_width: 0
            pad_all: 0
            scrollable: false
            layout:
              type: FLEX
              flex_flow: ROW_WRAP
              flex_align_main: START
              pad_row: 8
              pad_column: 8
            widgets:
              - button:
                  id: z1_btn
                  width: 98
                  height: 118
                  radius: 12
                  pad_all: 10
                  bg_color: 0xFFFFFF
                  shadow_width: 0
                  on_click:
                    - lambda: |-
                        id(cur_zone) = 1;
                        int m = ui::zone_number(1, "_minutes_by_hand");
                        id(run_min) = m > 0 ? m : 10;
                    - script.execute: refresh_zone
                    - lvgl.page.show: {id: zone_page, animation: MOVE_LEFT, time: 180ms}
                  widgets:
                    - label:
                        id: z1_name
                        align: TOP_LEFT
                        width: 100%
                        long_mode: WRAP
                        text_font: montserrat_18
                        text: "Zone 1"
                    - label:
                        id: z1_info
                        align: BOTTOM_LEFT
                        width: 100%
                        long_mode: WRAP
                        text_color: ${muted}
                        text_font: montserrat_14
                        text: ""
              - button:
                  id: z2_btn
                  width: 98
                  height: 118
                  radius: 12
                  pad_all: 10
                  bg_color: 0xFFFFFF
                  shadow_width: 0
                  on_click:
                    - lambda: |-
                        id(cur_zone) = 2;
                        int m = ui::zone_number(2, "_minutes_by_hand");
                        id(run_min) = m > 0 ? m : 10;
                    - script.execute: refresh_zone
                    - lvgl.page.show: {id: zone_page, animation: MOVE_LEFT, time: 180ms}
                  widgets:
                    - label:
                        id: z2_name
                        align: TOP_LEFT
                        width: 100%
                        long_mode: WRAP
                        text_font: montserrat_18
                        text: "Zone 2"
                    - label:
                        id: z2_info
                        align: BOTTOM_LEFT
                        width: 100%
                        long_mode: WRAP
                        text_color: ${muted}
                        text_font: montserrat_14
                        text: ""
              - button:
                  id: z3_btn
                  width: 98
                  height: 118
                  radius: 12
                  pad_all: 10
                  bg_color: 0xFFFFFF
                  shadow_width: 0
                  on_click:
                    - lambda: |-
                        id(cur_zone) = 3;
                        int m = ui::zone_number(3, "_minutes_by_hand");
                        id(run_min) = m > 0 ? m : 10;
                    - script.execute: refresh_zone
                    - lvgl.page.show: {id: zone_page, animation: MOVE_LEFT, time: 180ms}
                  widgets:
                    - label:
                        id: z3_name
                        align: TOP_LEFT
                        width: 100%
                        long_mode: WRAP
                        text_font: montserrat_18
                        text: "Zone 3"
                    - label:
                        id: z3_info
                        align: BOTTOM_LEFT
                        width: 100%
                        long_mode: WRAP
                        text_color: ${muted}
                        text_font: montserrat_14
                        text: ""
              - button:
                  id: z4_btn
                  width: 98
                  height: 118
                  radius: 12
                  pad_all: 10
                  bg_color: 0xFFFFFF
                  shadow_width: 0
                  on_click:
                    - lambda: |-
                        id(cur_zone) = 4;
                        int m = ui::zone_number(4, "_minutes_by_hand");
                        id(run_min) = m > 0 ? m : 10;
                    - script.execute: refresh_zone
                    - lvgl.page.show: {id: zone_page, animation: MOVE_LEFT, time: 180ms}
                  widgets:
                    - label:
                        id: z4_name
                        align: TOP_LEFT
                        width: 100%
                        long_mode: WRAP
                        text_font: montserrat_18
                        text: "Zone 4"
                    - label:
                        id: z4_info
                        align: BOTTOM_LEFT
                        width: 100%
                        long_mode: WRAP
                        text_color: ${muted}
                        text_font: montserrat_14
                        text: ""
              - button:
                  id: z5_btn
                  width: 98
                  height: 118
                  radius: 12
                  pad_all: 10
                  bg_color: 0xFFFFFF
                  shadow_width: 0
                  on_click:
                    - lambda: |-
                        id(cur_zone) = 5;
                        int m = ui::zone_number(5, "_minutes_by_hand");
                        id(run_min) = m > 0 ? m : 10;
                    - script.execute: refresh_zone
                    - lvgl.page.show: {id: zone_page, animation: MOVE_LEFT, time: 180ms}
                  widgets:
                    - label:
                        id: z5_name
                        align: TOP_LEFT
                        width: 100%
                        long_mode: WRAP
                        text_font: montserrat_18
                        text: "Zone 5"
                    - label:
                        id: z5_info
                        align: BOTTOM_LEFT
                        width: 100%
                        long_mode: WRAP
                        text_color: ${muted}
                        text_font: montserrat_14
                        text: ""
              - button:
                  id: z6_btn
                  width: 98
                  height: 118
                  radius: 12
                  pad_all: 10
                  bg_color: 0xFFFFFF
                  shadow_width: 0
                  on_click:
                    - lambda: |-
                        id(cur_zone) = 6;
                        int m = ui::zone_number(6, "_minutes_by_hand");
                        id(run_min) = m > 0 ? m : 10;
                    - script.execute: refresh_zone
                    - lvgl.page.show: {id: zone_page, animation: MOVE_LEFT, time: 180ms}
                  widgets:
                    - label:
                        id: z6_name
                        align: TOP_LEFT
                        width: 100%
                        long_mode: WRAP
                        text_font: montserrat_18
                        text: "Zone 6"
                    - label:
                        id: z6_info
                        align: BOTTOM_LEFT
                        width: 100%
                        long_mode: WRAP
                        text_color: ${muted}
                        text_font: montserrat_14
                        text: ""
              - button:
                  id: z7_btn
                  width: 98
                  height: 118
                  radius: 12
                  pad_all: 10
                  bg_color: 0xFFFFFF
                  shadow_width: 0
                  on_click:
                    - lambda: |-
                        id(cur_zone) = 7;
                        int m = ui::zone_number(7, "_minutes_by_hand");
                        id(run_min) = m > 0 ? m : 10;
                    - script.execute: refresh_zone
                    - lvgl.page.show: {id: zone_page, animation: MOVE_LEFT, time: 180ms}
                  widgets:
                    - label:
                        id: z7_name
                        align: TOP_LEFT
                        width: 100%
                        long_mode: WRAP
                        text_font: montserrat_18
                        text: "Zone 7"
                    - label:
                        id: z7_info
                        align: BOTTOM_LEFT
                        width: 100%
                        long_mode: WRAP
                        text_color: ${muted}
                        text_font: montserrat_14
                        text: ""
              - button:
                  id: z8_btn
                  width: 98
                  height: 118
                  radius: 12
                  pad_all: 10
                  bg_color: 0xFFFFFF
                  shadow_width: 0
                  on_click:
                    - lambda: |-
                        id(cur_zone) = 8;
                        int m = ui::zone_number(8, "_minutes_by_hand");
                        id(run_min) = m > 0 ? m : 10;
                    - script.execute: refresh_zone
                    - lvgl.page.show: {id: zone_page, animation: MOVE_LEFT, time: 180ms}
                  widgets:
                    - label:
                        id: z8_name
                        align: TOP_LEFT
                        width: 100%
                        long_mode: WRAP
                        text_font: montserrat_18
                        text: "Zone 8"
                    - label:
                        id: z8_info
                        align: BOTTOM_LEFT
                        width: 100%
                        long_mode: WRAP
                        text_color: ${muted}
                        text_font: montserrat_14
                        text: ""

    # ── One zone: run it by hand (the cog opens its settings) ──
    - id: zone_page
      styles: page_style
      scrollable: false
      on_swipe_right:
        - lvgl.page.show: {id: zones_page, animation: MOVE_RIGHT, time: 180ms}
      widgets:
        - button:
            styles: back_btn
            align: TOP_LEFT
            x: -8
            on_click: {lvgl.page.show: {id: zones_page, animation: MOVE_RIGHT, time: 180ms}}
            widgets:
              - label:
                  align: CENTER
                  text_font: icons_28
                  text_color: ${ink}
                  text: "\U000F0141"
        - label:
            id: zd_title
            align: TOP_LEFT
            x: 40
            y: 4
            text_font: montserrat_24
            text: ""
        - button:
            styles: back_btn
            align: TOP_RIGHT
            on_click: {lvgl.page.show: {id: zone_settings_page, animation: MOVE_LEFT, time: 180ms}}
            widgets:
              - label:
                  align: CENTER
                  text_font: icons_28
                  text_color: ${muted}
                  text: "\U000F0493"
        - obj:
            styles: card_style
            align: BOTTOM_MID
            width: 100%
            height: 248
            scrollable: false
            widgets:
              - label:
                  id: zd_head
                  align: TOP_LEFT
                  text_color: ${muted}
                  text_font: montserrat_16
                  text: "Run by hand for"
              - label:
                  id: zd_last
                  align: TOP_RIGHT
                  text_color: ${muted}
                  text_font: montserrat_16
                  text: ""
              - button:
                  id: zd_minus
                  align: CENTER
                  x: -120
                  y: -22
                  width: 56
                  height: 56
                  radius: 28
                  bg_color: 0xE9EEF2
                  shadow_width: 0
                  on_click:
                    - lambda: |-
                        if (id(run_min) > 1) id(run_min)--;
                        ui::link().set(ui::zkey(id(cur_zone), "number", "_minutes_by_hand"), std::to_string(id(run_min)));
                    - script.execute: refresh_zone
                  widgets: [{label: {align: CENTER, text_font: montserrat_28, text: "-"}}]
              - label:
                  id: zd_min
                  align: CENTER
                  y: -30
                  text_font: montserrat_28
                  text: "10"
              - label:
                  id: zd_unit
                  align: CENTER
                  y: -2
                  text_color: ${muted}
                  text_font: montserrat_16
                  text: "minutes"
              - button:
                  id: zd_plus
                  align: CENTER
                  x: 120
                  y: -22
                  width: 56
                  height: 56
                  radius: 28
                  bg_color: 0xE9EEF2
                  shadow_width: 0
                  on_click:
                    - lambda: |-
                        if (id(run_min) < 120) id(run_min)++;
                        ui::link().set(ui::zkey(id(cur_zone), "number", "_minutes_by_hand"), std::to_string(id(run_min)));
                    - script.execute: refresh_zone
                  widgets: [{label: {align: CENTER, text_font: montserrat_28, text: "+"}}]
              - button:
                  id: zd_run
                  align: BOTTOM_MID
                  width: 100%
                  height: 58
                  radius: 12
                  bg_color: 0x2E7D32
                  shadow_width: 0
                  on_click:
                    # Run: the minutes first, then (a moment later, so the A8 has surely taken them)
                    # the zone. Stop: at once.
                    - lambda: |-
                        const int n = id(cur_zone);
                        id(run_zone_pending) = 0;
                        if (ui::zone_running(n)) {
                          ui::link().set(ui::link().zone_key(n), "0");
                        } else {
                          ui::link().set(ui::zkey(n, "number", "_minutes_by_hand"), std::to_string(id(run_min)));
                          id(run_zone_pending) = n;
                        }
                    - if:
                        condition:
                          lambda: return id(run_zone_pending) > 0;
                        then:
                          - delay: 250ms
                          - lambda: |-
                              const int n = id(run_zone_pending);
                              id(run_zone_pending) = 0;
                              if (n > 0 && !ui::zone_running(n)) ui::link().set(ui::link().zone_key(n), "1");
                  widgets:
                    - label:
                        id: zd_run_label
                        align: CENTER
                        text_font: montserrat_24
                        text_color: 0xFFFFFF
                        text: "Run"

    # ── One zone's settings, in plain words ──
    - id: zone_settings_page
      styles: page_style
      scrollable: false
      on_swipe_right:
        - lvgl.page.show: {id: zone_page, animation: MOVE_RIGHT, time: 180ms}
      widgets:
        - button:
            styles: back_btn
            align: TOP_LEFT
            x: -8
            on_click: {lvgl.page.show: {id: zone_page, animation: MOVE_RIGHT, time: 180ms}}
            widgets:
              - label:
                  align: CENTER
                  text_font: icons_28
                  text_color: ${ink}
                  text: "\U000F0141"
        - label:
            id: zs_title
            align: TOP_LEFT
            x: 40
            y: 4
            text_font: montserrat_24
            text: ""
        - button:
            styles: back_btn
            align: TOP_RIGHT
            on_click:
              - lambda: |-
                  ui::ta_set(id(rn_text), ui::zone_name(id(cur_zone)));
              - lvgl.widget.show: rn_sheet
            widgets:
              - label:
                  align: CENTER
                  text_font: icons_28
                  text_color: 0x1E6091
                  text: "\U000F03EB"
        - obj:
            styles: card_style
            align: BOTTOM_MID
            width: 100%
            height: 248
            pad_top: 8
            pad_bottom: 8
            scrollable: false
            widgets:
              - label: {align: TOP_LEFT, y: 2, text_font: montserrat_18, text: "Enabled"}
              - label: {align: TOP_LEFT, y: 26, text_color: "${muted}", text_font: montserrat_14, text: "Off = programs skip this zone"}
              - switch:
                  id: zd_enabled
                  align: TOP_RIGHT
                  y: 8
                  width: 64
                  height: 34
                  on_change:
                    - lambda: 'ui::link().set(ui::zkey(id(cur_zone), "switch", "_enabled"), x ? "1" : "0");'
              - label: {align: TOP_LEFT, y: 58, text_font: montserrat_18, text: "Longest run (min)"}
              - label: {align: TOP_LEFT, y: 82, text_color: "${muted}", text_font: montserrat_14, text: "Safety cap for one run"}
              - button:
                  align: TOP_RIGHT
                  x: -96
                  y: 60
                  width: 44
                  height: 44
                  radius: 22
                  bg_color: 0xE9EEF2
                  shadow_width: 0
                  on_click:
                    - lambda: |-
                        int v = ui::zone_number(id(cur_zone), "_max_minutes");
                        if (v > 0) ui::link().set(ui::zkey(id(cur_zone), "number", "_max_minutes"), std::to_string(v - 1));
                  widgets: [{label: {align: CENTER, text_font: montserrat_24, text: "-"}}]
              - label:
                  id: zd_max
                  align: TOP_RIGHT
                  x: -48
                  y: 70
                  width: 48
                  text_align: CENTER
                  text_font: montserrat_20
                  text: ""
              - button:
                  align: TOP_RIGHT
                  y: 60
                  width: 44
                  height: 44
                  radius: 22
                  bg_color: 0xE9EEF2
                  shadow_width: 0
                  on_click:
                    - lambda: |-
                        int v = ui::zone_number(id(cur_zone), "_max_minutes");
                        ui::link().set(ui::zkey(id(cur_zone), "number", "_max_minutes"), std::to_string(v + 1));
                  widgets: [{label: {align: CENTER, text_font: montserrat_24, text: "+"}}]
              - label: {align: TOP_LEFT, y: 116, text_font: montserrat_18, text: "Water in bursts of (min)"}
              - label: {align: TOP_LEFT, y: 140, text_color: "${muted}", text_font: montserrat_14, text: "0 = all at once"}
              - button:
                  align: TOP_RIGHT
                  x: -96
                  y: 118
                  width: 44
                  height: 44
                  radius: 22
                  bg_color: 0xE9EEF2
                  shadow_width: 0
                  on_click:
                    - lambda: |-
                        int v = ui::zone_number(id(cur_zone), "_cycle_minutes");
                        if (v > 0) ui::link().set(ui::zkey(id(cur_zone), "number", "_cycle_minutes"), std::to_string(v - 1));
                  widgets: [{label: {align: CENTER, text_font: montserrat_24, text: "-"}}]
              - label:
                  id: zd_cycle
                  align: TOP_RIGHT
                  x: -48
                  y: 128
                  width: 48
                  text_align: CENTER
                  text_font: montserrat_20
                  text: ""
              - button:
                  align: TOP_RIGHT
                  y: 118
                  width: 44
                  height: 44
                  radius: 22
                  bg_color: 0xE9EEF2
                  shadow_width: 0
                  on_click:
                    - lambda: |-
                        int v = ui::zone_number(id(cur_zone), "_cycle_minutes");
                        ui::link().set(ui::zkey(id(cur_zone), "number", "_cycle_minutes"), std::to_string(v + 1));
                  widgets: [{label: {align: CENTER, text_font: montserrat_24, text: "+"}}]
              - label: {align: TOP_LEFT, y: 174, text_font: montserrat_18, text: "Pause between bursts (min)"}
              - label: {align: TOP_LEFT, y: 198, text_color: "${muted}", text_font: montserrat_14, text: "Lets the water soak in"}
              - button:
                  align: TOP_RIGHT
                  x: -96
                  y: 176
                  width: 44
                  height: 44
                  radius: 22
                  bg_color: 0xE9EEF2
                  shadow_width: 0
                  on_click:
                    - lambda: |-
                        int v = ui::zone_number(id(cur_zone), "_soak_minutes");
                        if (v > 0) ui::link().set(ui::zkey(id(cur_zone), "number", "_soak_minutes"), std::to_string(v - 1));
                  widgets: [{label: {align: CENTER, text_font: montserrat_24, text: "-"}}]
              - label:
                  id: zd_soak
                  align: TOP_RIGHT
                  x: -48
                  y: 186
                  width: 48
                  text_align: CENTER
                  text_font: montserrat_20
                  text: ""
              - button:
                  align: TOP_RIGHT
                  y: 176
                  width: 44
                  height: 44
                  radius: 22
                  bg_color: 0xE9EEF2
                  shadow_width: 0
                  on_click:
                    - lambda: |-
                        int v = ui::zone_number(id(cur_zone), "_soak_minutes");
                        ui::link().set(ui::zkey(id(cur_zone), "number", "_soak_minutes"), std::to_string(v + 1));
                  widgets: [{label: {align: CENTER, text_font: montserrat_24, text: "+"}}]
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
