saipurumandla/irrigation-ha/firmware/components/st77922_qspi/es3c35p_init.h

#pragma once
#include "esp_lcd_st77922.h"
// The LCDWIKI ES3C35P panel (320x480) needs its seller's table: with Espressif's default (written
// for a 532x300 panel) the ST77922 accepts commands but shows no image. Table layout and values
// copied from the factory firmware's st77922_lcd_init_cmd_t array (2026-11-05).
static const st77922_lcd_init_cmd_t ES3C35P_INIT[] = {
    {0xF1, (uint8_t[]){0x00}, 1, 0},
    {0x60, (uint8_t[]){0x00, 0x00, 0x00}, 3, 0},
    {0x65, (uint8_t[]){0x80}, 1, 0},
    {0x79, (uint8_t[]){0x06}, 1, 0},
    {0x7B, (uint8_t[]){0x00, 0x08, 0x08}, 3, 0},
    {0x80, (uint8_t[]){0x55, 0x62, 0x2F, 0x17, 0xF0, 0x52, 0x70, 0xD2, 0x52, 0x62, 0xEA}, 11, 0},
    {0x81, (uint8_t[]){0x26, 0x52, 0x72, 0x27}, 4, 0},
    {0x84, (uint8_t[]){0x92, 0x25}, 2, 0},
    {0x87, (uint8_t[]){0x10, 0x10, 0x58, 0x00, 0x02, 0x3A}, 6, 0},
    {0x88, (uint8_t[]){0x00, 0x00, 0x2C, 0x10, 0x04, 0x00, 0x00, 0x00, 0x01, 0x01, 0x01, 0x01, 0x01, 0x00, 0x06}, 15, 0},
    {0x89, (uint8_t[]){0x00, 0x00, 0x00}, 3, 0},
    {0x8A, (uint8_t[]){0x13, 0x00, 0x2C, 0x00, 0x00, 0x2C, 0x10, 0x10, 0x00, 0x3E, 0x19}, 11, 0},
    {0x8B, (uint8_t[]){0x15, 0xB1, 0xB1, 0x44, 0x96, 0x2C, 0x10, 0x97, 0x8E}, 9, 0},
    {0x8C, (uint8_t[]){0x1D, 0xB1, 0xB1, 0x44, 0x96, 0x2C, 0x10, 0x50, 0x0F, 0x01, 0xC5, 0x12, 0x09}, 13, 0},
    {0x8D, (uint8_t[]){0x0C}, 1, 0},
    {0x8E, (uint8_t[]){0x33, 0x01, 0x0C, 0x13, 0x01, 0x01}, 6, 0},
    {0xB3, (uint8_t[]){0x00, 0x30}, 2, 0},
    {0xF1, (uint8_t[]){0x00}, 1, 0},
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
    {0x21, (uint8_t[]){0x00}, 0, 0},
    {0x11, (uint8_t[]){0x00}, 0, 120},
    {0x29, (uint8_t[]){0x00}, 0, 0},
    {0x2C, (uint8_t[]){0x00}, 0, 0},
    {0x3A, (uint8_t[]){0x01}, 1, 0},
    {0x36, (uint8_t[]){0x00}, 1, 0},
    {0x35, (uint8_t[]){0x01}, 1, 20},
};
