saipurumandla/irrigation-ha/(commit log)

2026-11-02 case: A8 measured, and the rail-mount model's hole pattern
2026-11-02 case: slots instead of a hole per relay screw
2026-11-02 case: layout confirmed
2026-11-02 case: terminal strip, Wago, gland and insert sizes
2026-11-02 case: EVEPS converter size
2026-11-02 case: CPT converter size
2026-11-02 case: valve wires in through the back
2026-11-02 case: screen size from the seller's picture
2026-11-02 case: rain and flow sensors only
2026-11-02 case: first OpenSCAD model
    [irrigation_case.scad]
2026-11-02 case: the A8's orientation confirmed
    [irrigation_case.scad]
2026-11-02 case: fit-test plate
    [irrigation_case.scad]
2026-11-02 case: the screen measured
    [irrigation_case.scad]
2026-11-02 case: lid's microphone hole where the board has it
    [irrigation_case.scad]
2026-11-02 case: base plate screwed to the box
    [irrigation_case.scad]
2026-11-02 case: M2 screws for the screen and the A8
    [irrigation_case.scad]
2026-11-02 case: M3 for the screen
    [irrigation_case.scad]
2026-11-02 case: screen screw holes 1 mm into the lid
    [irrigation_case.scad]
2026-11-02 case: screw joints fixed
    [irrigation_case.scad]
2026-11-02 case: insert hole 4.2
    [irrigation_case.scad]
2026-11-02 case: two-colour labels
    [irrigation_case.scad]
2026-11-03 case: M3 for the A8 too
    [irrigation_case.scad]
2026-11-03 case: A8 standoffs confirmed on the test print
2026-11-03 case: converters measured 46.25 / 46.6 mm wide
    [irrigation_case.scad]
2026-11-03 case: Wagos sit loose in the power bay
    [irrigation_case.scad]
2026-11-03 case: converters on M3 nut rails
    [irrigation_case.scad]
2026-11-03 case: 0.6 mm play in the terminal strip trays
    [irrigation_case.scad]
2026-11-03 case: PG7 hole and keyholes confirmed
2026-11-03 case: wiring cover hooks in at the top
    [irrigation_case.scad]
2026-11-03 case: terminal strips press-fit
2026-11-03 case: terminal strip trays press-fit in the model
    [irrigation_case.scad]
2026-11-03 case: strip tray walls back to 2 mm
    [irrigation_case.scad]
2026-11-03 case: strip clip clamps
    [irrigation_case.scad]
2026-11-03 case: where it stands and the next steps
2026-11-03 case: screen fit test piece
    [irrigation_case.scad]
2026-11-03 case: insert hole 4.2 mm confirmed in PETG
    [irrigation_case.scad]
2026-11-03 case: nut rail confirmed in PETG
2026-11-03 case: terminal strip trays back to the exact size
    [irrigation_case.scad]
2026-11-03 case: lid, covers and clips exported face down for printing
    [irrigation_case.scad]
2026-11-03 case: straight vent slots, a mesh inside if needed
2026-11-03 case: one colour, water drop on the lid
    [irrigation_case.scad]
2026-11-03 case: screen posts 3.5 mm so the glass rests against the lid
    [irrigation_case.scad]
2026-11-03 case: screen holes 89.7 x 51.2 mm
    [irrigation_case.scad]
2026-11-03 case: 45-degree slopes under the overhangs
    [irrigation_case.scad]
2026-11-03 case: no wire-colour table in the wiring cover
    [irrigation_case.scad]
2026-11-03 case: black inlays
    [irrigation_case.scad]
2026-11-06 case: lid and cover fixes
    [irrigation_case.scad]
2026-11-06 screen: ES3C35P firmware, ST77922 driver, wired A8 link
2026-11-06 screen: fix run minutes and stuck watering
    [irrigation-screen.yaml]
2026-11-06 case: wall template and transformer boot
    [irrigation_case.scad, transformer_cover.scad]
2026-11-06 tidy paths, add STLs
    [base.stl, box.stl, clips.stl, clips_labels.stl, lid.stl, thumb_knob.stl, transformer_cover.stl, wall_template.stl]
2026-11-06 add a Zones map sensor for dashboards
